c3h899/Full-Range-Speaker/Physical Cabinate/CAD Model/Cabinate_Assm_2.pdf

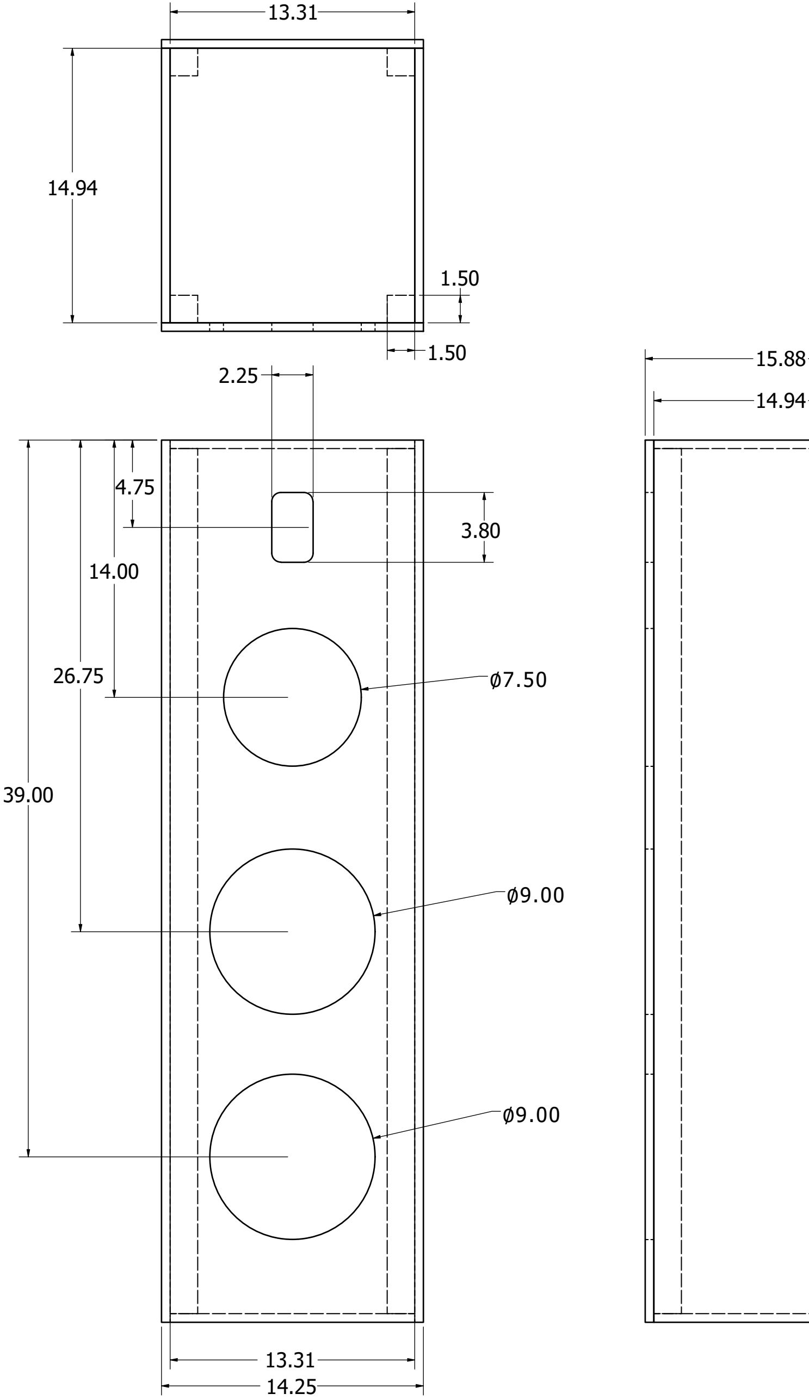
[picture p19: figure]

48.00

47.06
