c3h899/Full-Range-Speaker/Crossover Designs/Active Prototype [0] (Images)/PXL_20211031_224618647.jpg

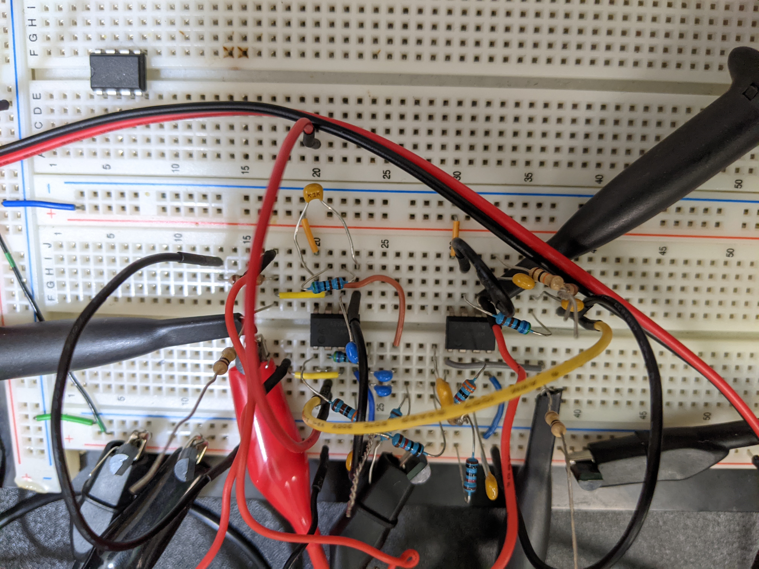
Crossover Designs/Active Prototype [0] (Images)/PXL_20211031_224618647.jpg
