c3h899/Full-Range-Speaker/Crossover Designs/Active Prototype [0] (Images)/PXL_20211031_230953043.jpg

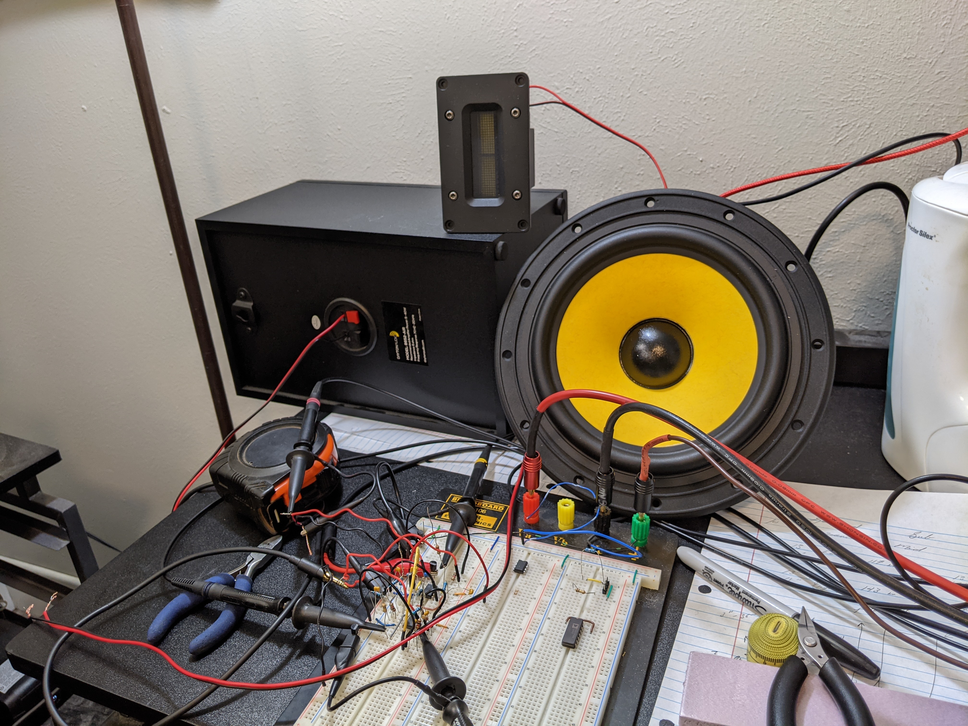
Crossover Designs/Active Prototype [0] (Images)/PXL_20211031_230953043.jpg
