c3h899/Full-Range-Speaker/Crossover Designs/Active/TPA3244 Ex Circ.PNG

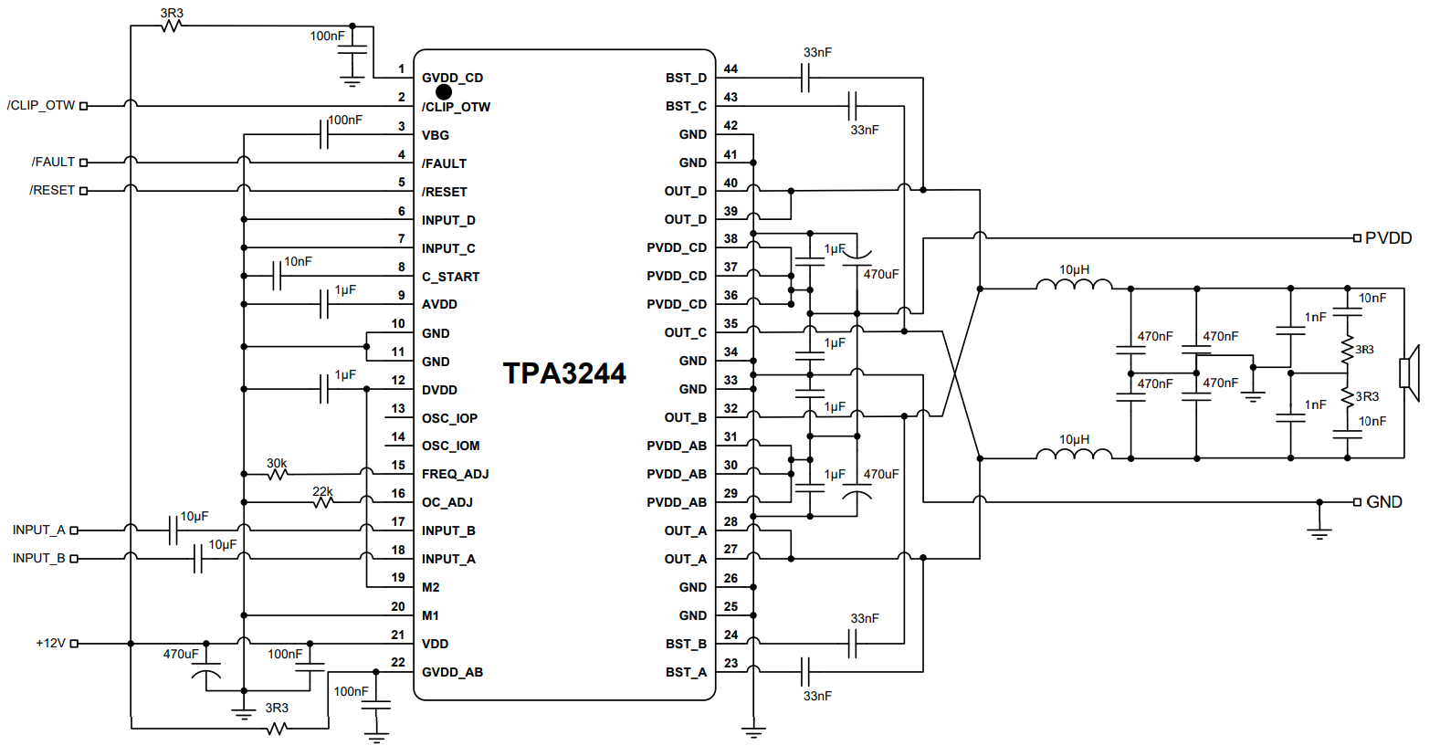
Crossover Designs/Active/TPA3244 Ex Circ.PNG
