c3h899/Full-Range-Speaker/Design Concept/Stock Photos/Dayton Audio DS270-PR (Passive Radiator).jpg

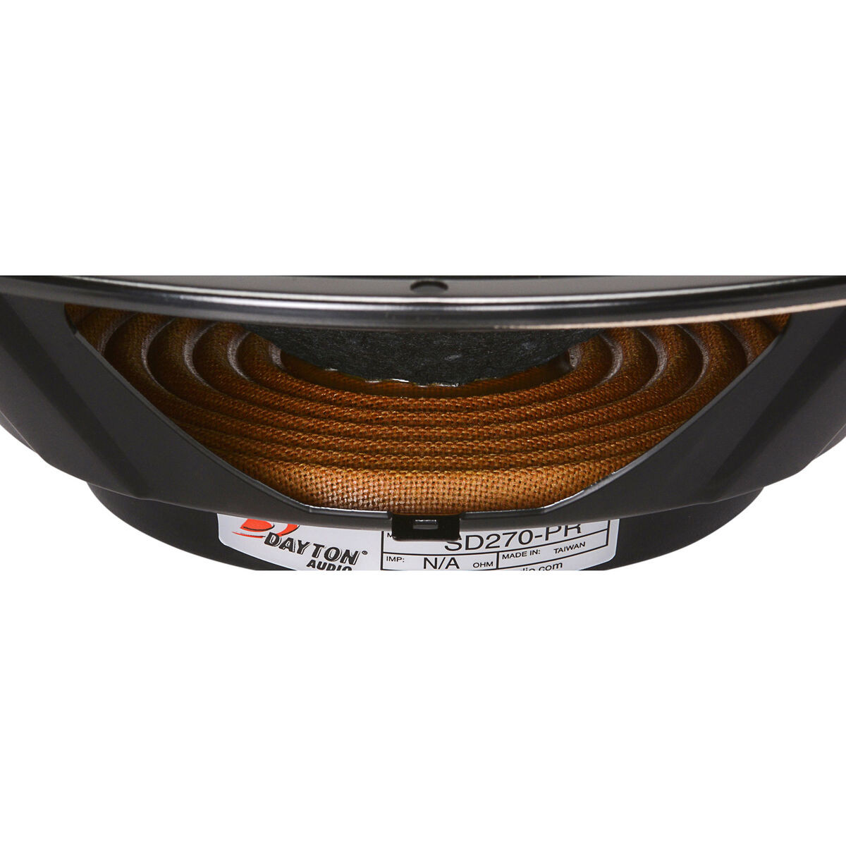
Design Concept/Stock Photos/Dayton Audio DS270-PR (Passive Radiator).jpg
