c3h899/Full-Range-Speaker/Design Concept/Stock Photos/Dayton Audio SD270A-88.jpg

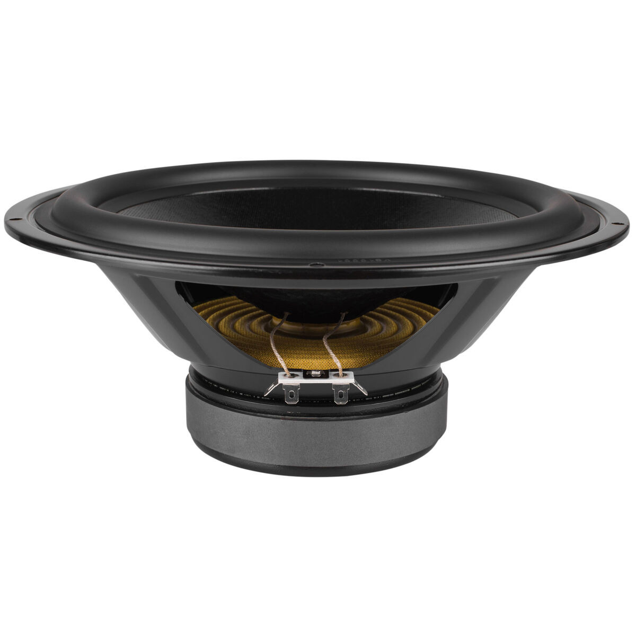
Design Concept/Stock Photos/Dayton Audio SD270A-88.jpg
