c3h899/Full-Range-Speaker/Design Concept/Stock Photos/Fountek Neo X 2.0 Ribbon Tweeter.jpg

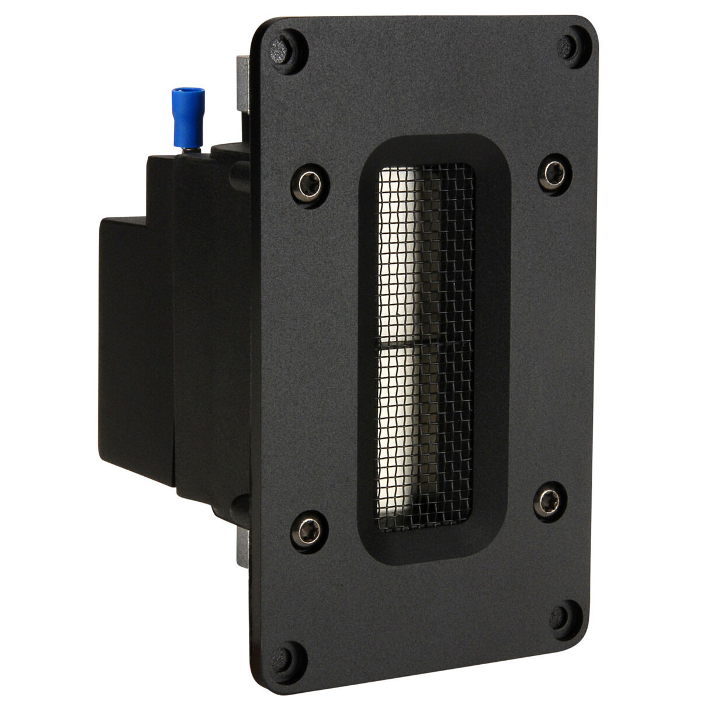
Design Concept/Stock Photos/Fountek Neo X 2.0 Ribbon Tweeter.jpg
