c3h899/Full-Range-Speaker/Design Concept/Stock Photos/Fountek, Neo CD 3.0 (Future Question).jpg

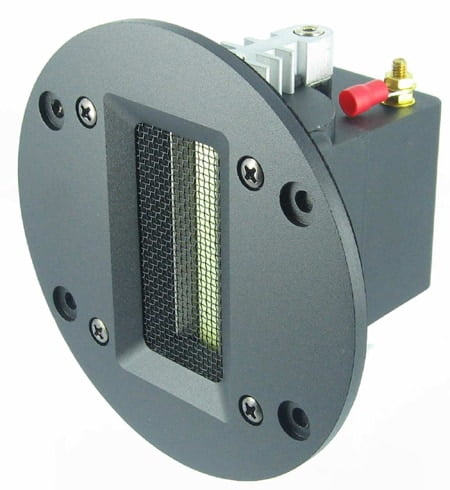
Design Concept/Stock Photos/Fountek, Neo CD 3.0 (Future Question).jpg
