c3h899/Full-Range-Speaker/Design Concept/Stock Photos/Hi-Vi, F6.jpg

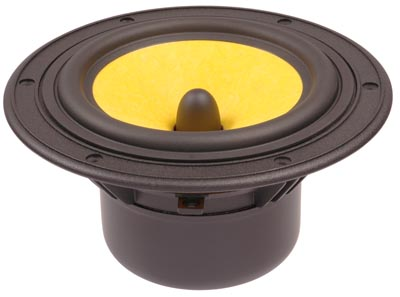
Design Concept/Stock Photos/Hi-Vi, F6.jpg
