c3h899/Full-Range-Speaker/Design Concept/Stock Photos/HiVi F8.jpg

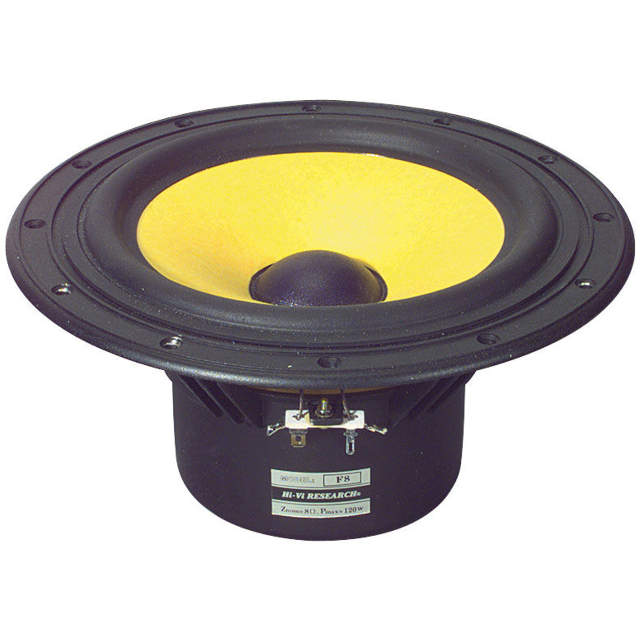
Design Concept/Stock Photos/HiVi F8.jpg
