c3h899/Full-Range-Speaker/Driver Impedance (DATS V3)/Cabinet/Drivers_In_Place.png

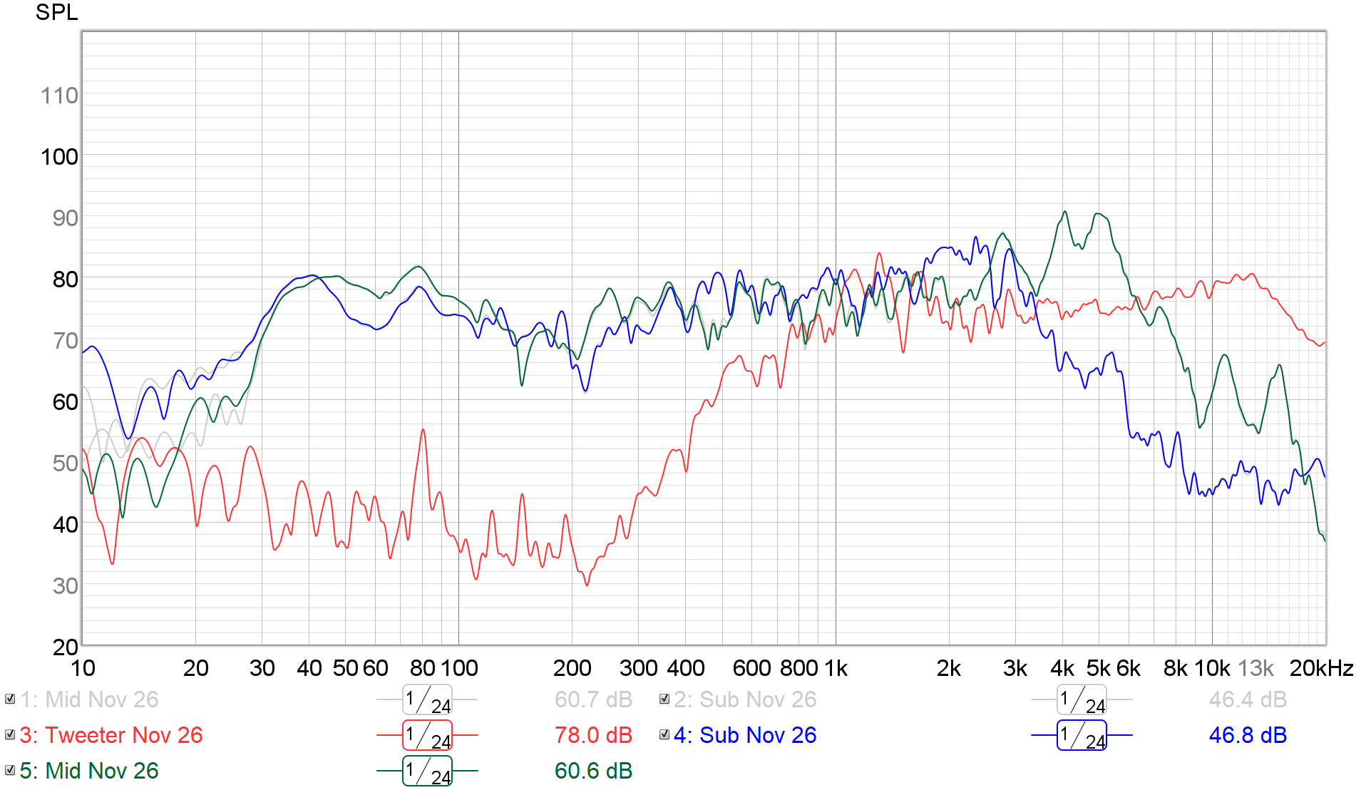
Driver Impedance (DATS V3)/Cabinet/Drivers_In_Place.png
