c3h899/Full-Range-Speaker/Driver Impedance (DATS V3)/Cabinet/Mid-Bass.png

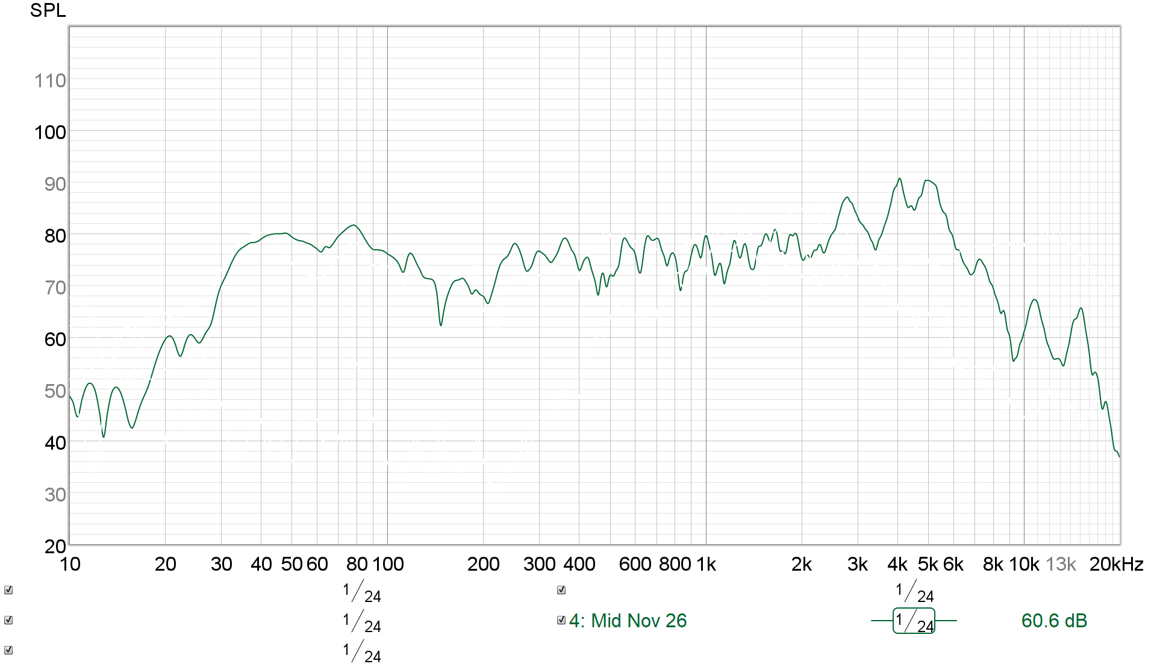
Driver Impedance (DATS V3)/Cabinet/Mid-Bass.png
