c3h899/Full-Range-Speaker/Driver Impedance (DATS V3)/Cabinet/Sub.png

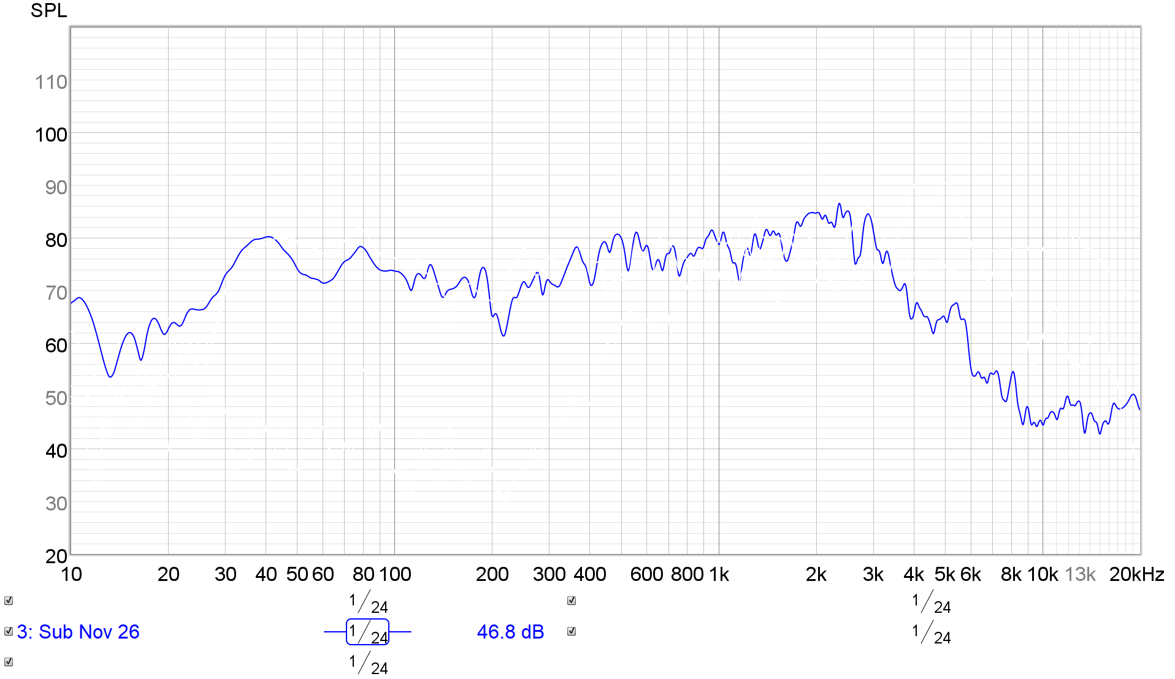
Driver Impedance (DATS V3)/Cabinet/Sub.png
