c3h899/Full-Range-Speaker/Driver Impedance (DATS V3)/Cabinet/Tweeter.png

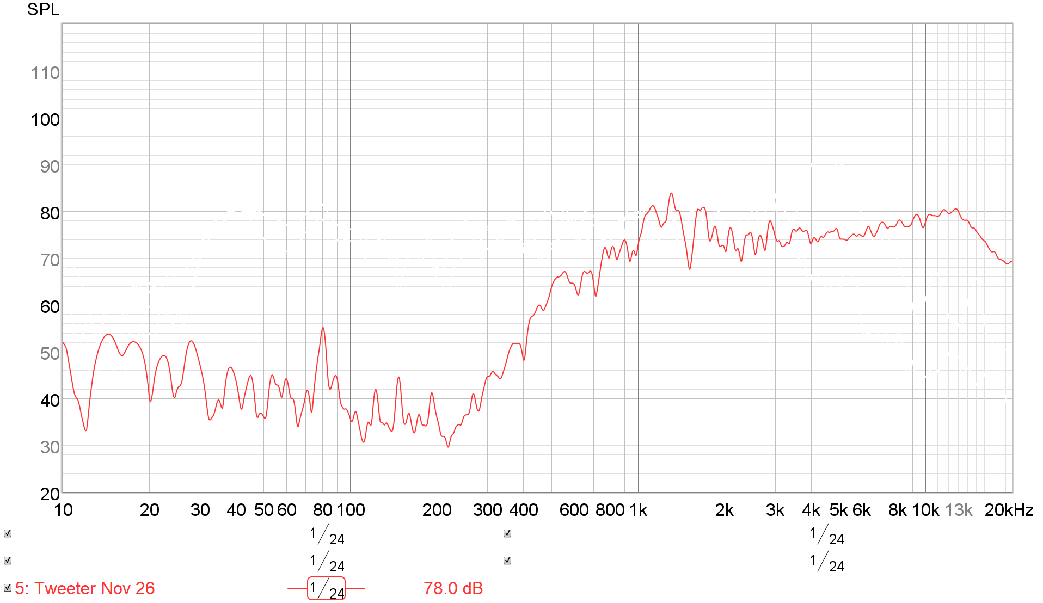
Driver Impedance (DATS V3)/Cabinet/Tweeter.png
