c3h899/Full-Range-Speaker/Physical Cabinate/Cabling [Images]/CableMatters Wall Plate (Rear) Only Banana Plug Compatible.jpg

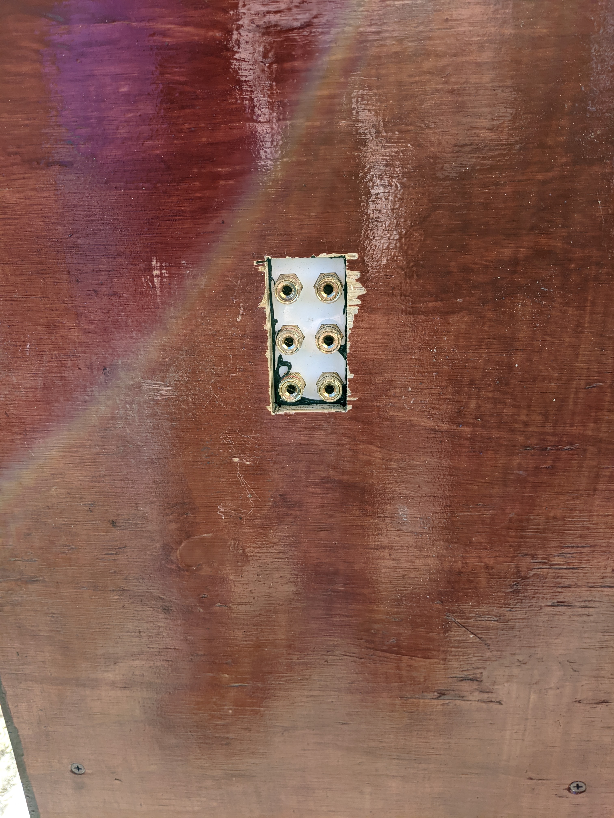
Physical Cabinate/Cabling [Images]/CableMatters Wall Plate (Rear) Only Banana Plug Compatible.jpg
