c3h899/Full-Range-Speaker/Physical Cabinate/Cabling [Images]/CableMatters Wall Plate.jpg

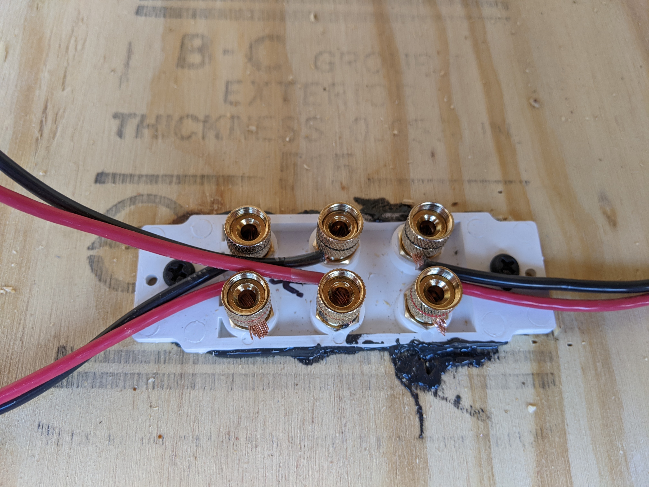
Physical Cabinate/Cabling [Images]/CableMatters Wall Plate.jpg
