c3h899/Full-Range-Speaker/Physical Cabinate/Cabling [Images]/Mid-Bass Cabling.jpg

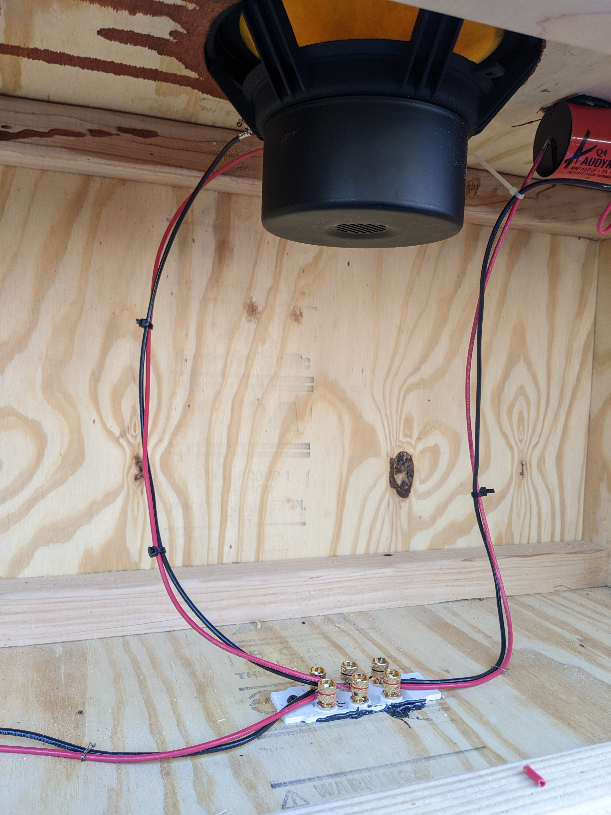
Physical Cabinate/Cabling [Images]/Mid-Bass Cabling.jpg
