c3h899/Full-Range-Speaker/Physical Cabinate/Cabling [Images]/Sub Cabling.jpg

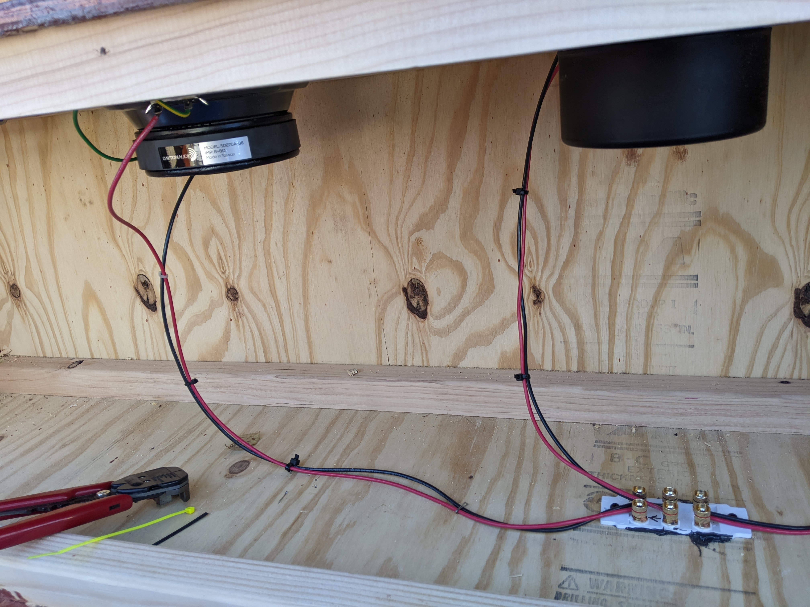
Physical Cabinate/Cabling [Images]/Sub Cabling.jpg
