c3h899/Full-Range-Speaker/Physical Cabinate/Cabling [Images]/Tweeter Cabling.jpg

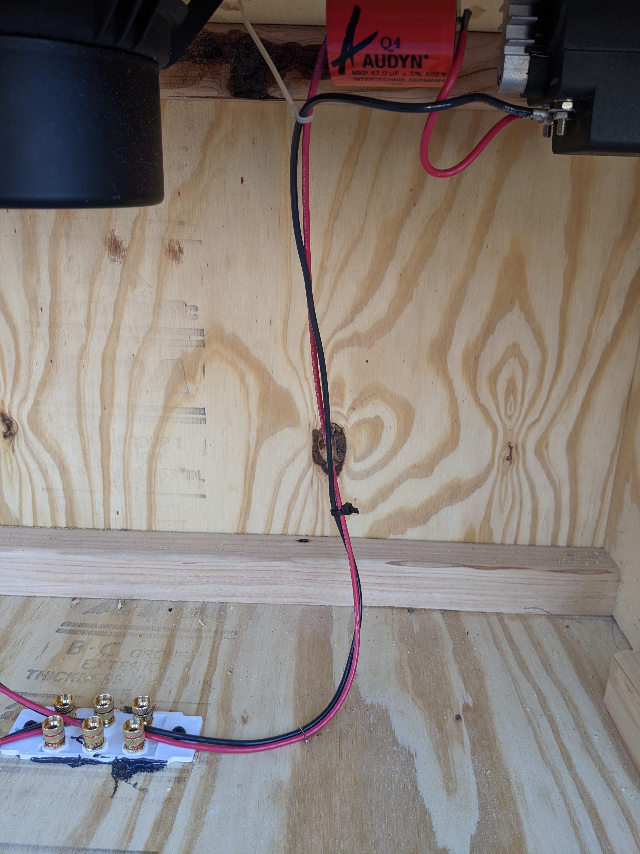
Physical Cabinate/Cabling [Images]/Tweeter Cabling.jpg
