c3h899/Full-Range-Speaker/Physical Cabinate/Cabling [Images]/Tweeter Series Cap.jpg

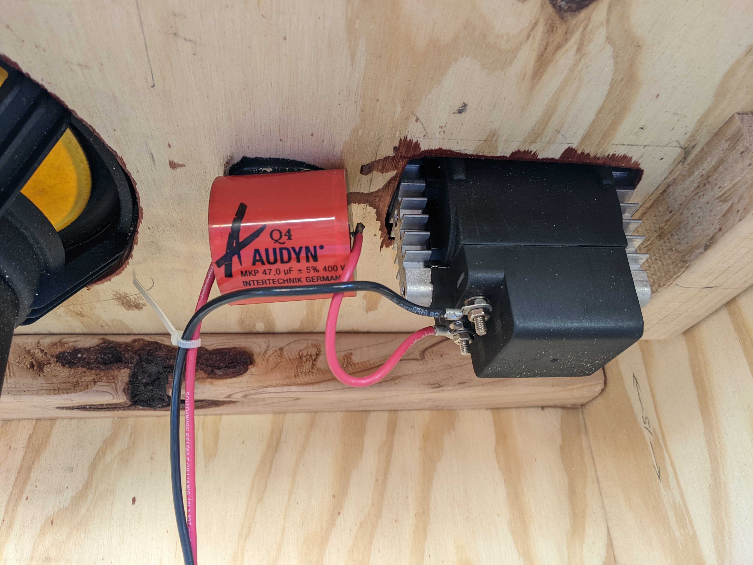
Physical Cabinate/Cabling [Images]/Tweeter Series Cap.jpg
