c3h899/Full-Range-Speaker/Physical Cabinate/Simulation (WinISD)/Not_Quite_Matched.png

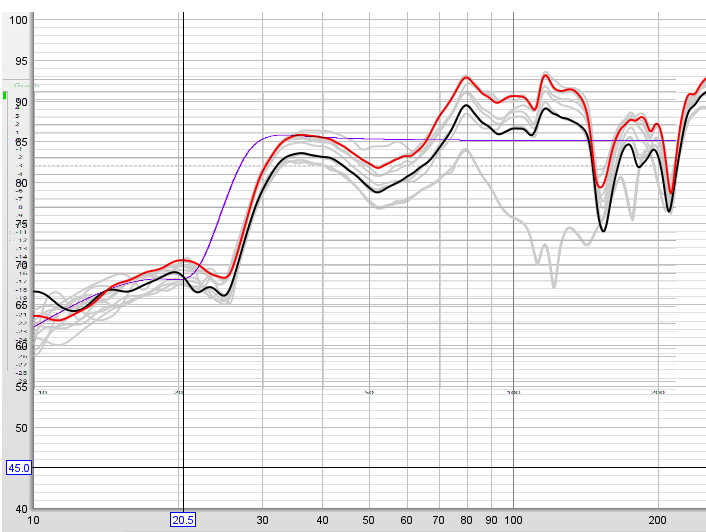
Physical Cabinate/Simulation (WinISD)/Not_Quite_Matched.png
