c3h899/Full-Range-Speaker/Power_Amplifier/R0.2_Images/PXL_20211216_221555118.jpg

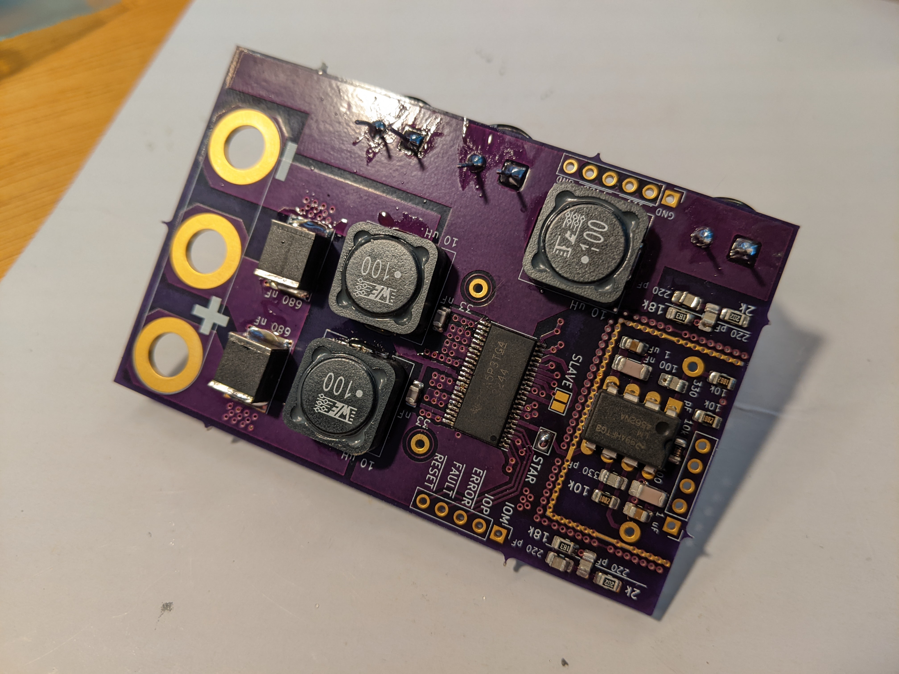
Power_Amplifier/R0.2_Images/PXL_20211216_221555118.jpg
