c3h899/Full-Range-Speaker/Power_Amplifier/R0.2_Images/PXL_20211222_185317508.jpg

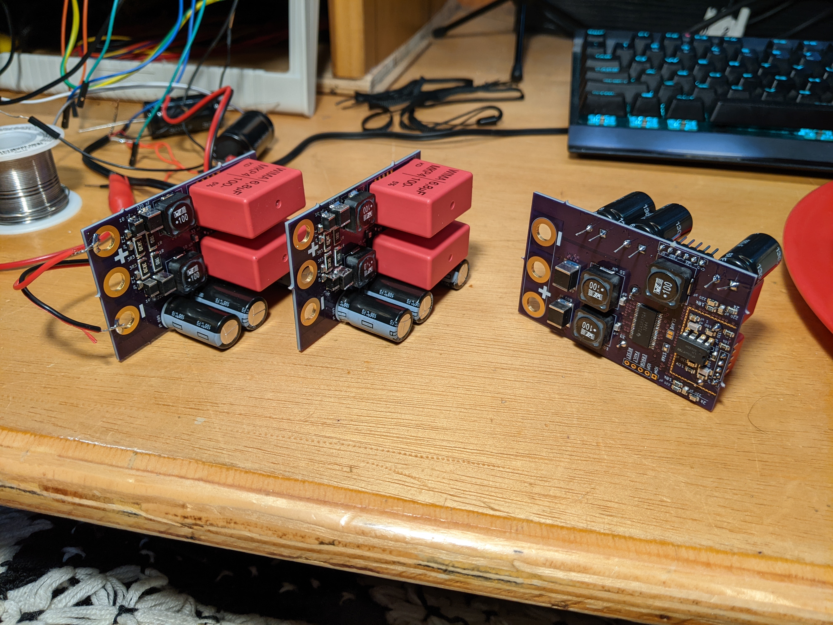
Power_Amplifier/R0.2_Images/PXL_20211222_185317508.jpg
