c3h899/Full-Range-Speaker/Power_Amplifier/R0.2_Images/PXL_20211222_185340925.jpg

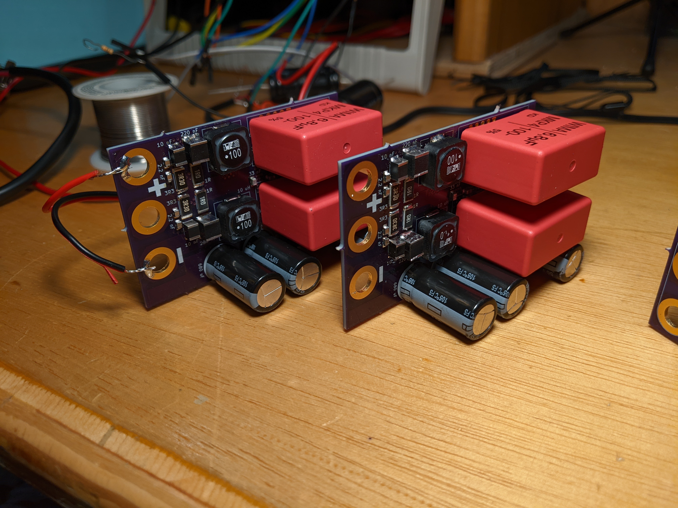
Power_Amplifier/R0.2_Images/PXL_20211222_185340925.jpg
