c3h899/Full-Range-Speaker/Power_Amplifier/R0.2_Plot/Discrete_Channel_Bot.png

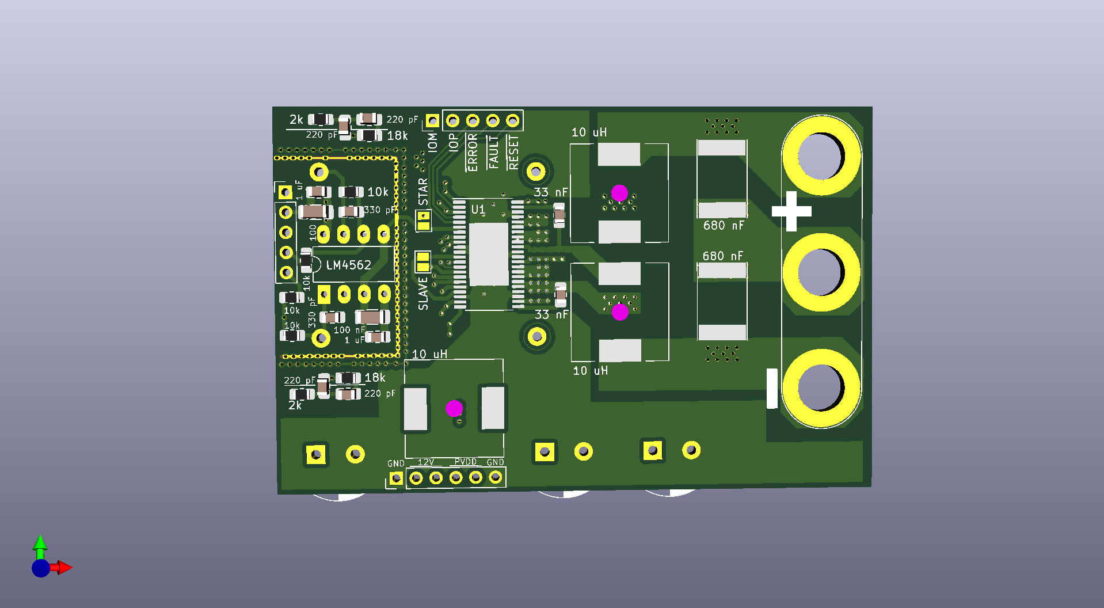
Power_Amplifier/R0.2_Plot/Discrete_Channel_Bot.png
