c3h899/Full-Range-Speaker/Power_Amplifier/R0_Images/Board_Bot_WIMA_Caps.jpg

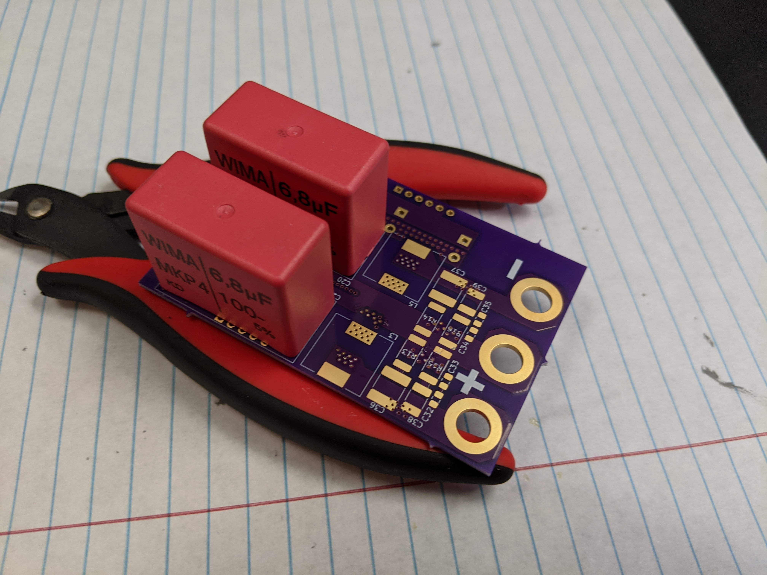
Power_Amplifier/R0_Images/Board_Bot_WIMA_Caps.jpg
