c3h899/Full-Range-Speaker/Power_Amplifier/R0_Images/Board_Empty_Bottom.jpg

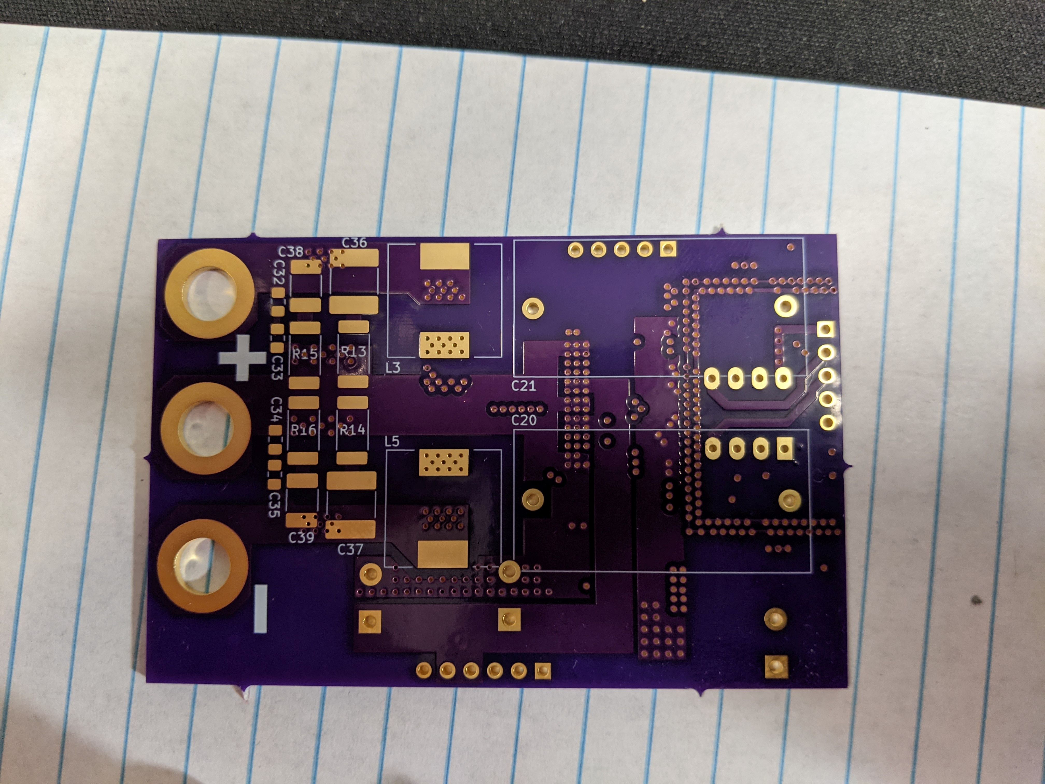
Power_Amplifier/R0_Images/Board_Empty_Bottom.jpg
