c3h899/Full-Range-Speaker/Power_Amplifier/R0_Images/Board_Top_Profile.jpg

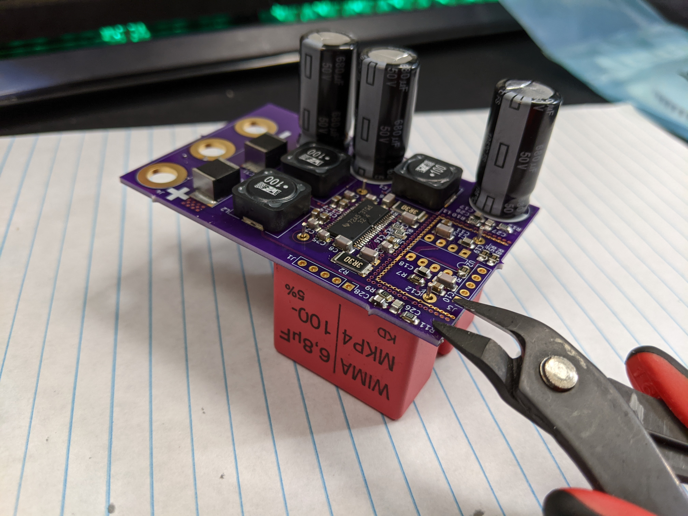
Power_Amplifier/R0_Images/Board_Top_Profile.jpg
