c3h899/Full-Range-Speaker/Power_Amplifier/R0_Images/Board_Top_Profile_2.jpg

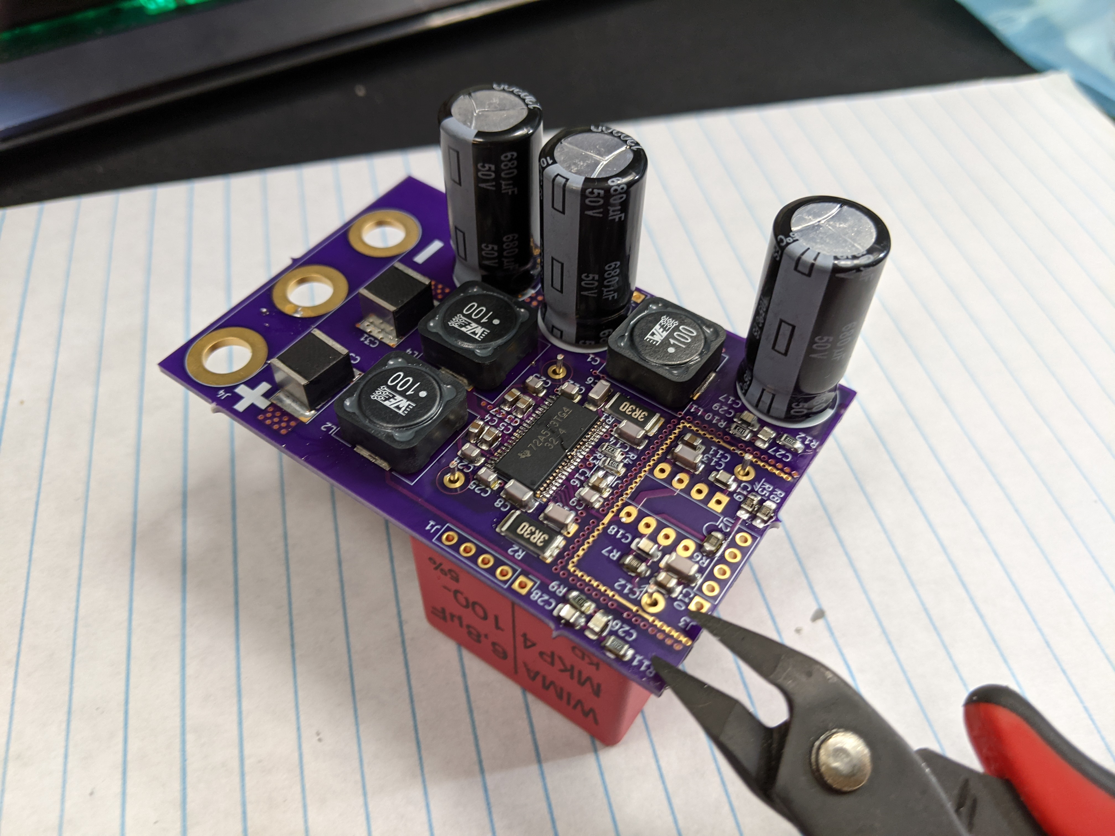
Power_Amplifier/R0_Images/Board_Top_Profile_2.jpg
