c3h899/Full-Range-Speaker/Report/Images/sp_active_xover_poc.png

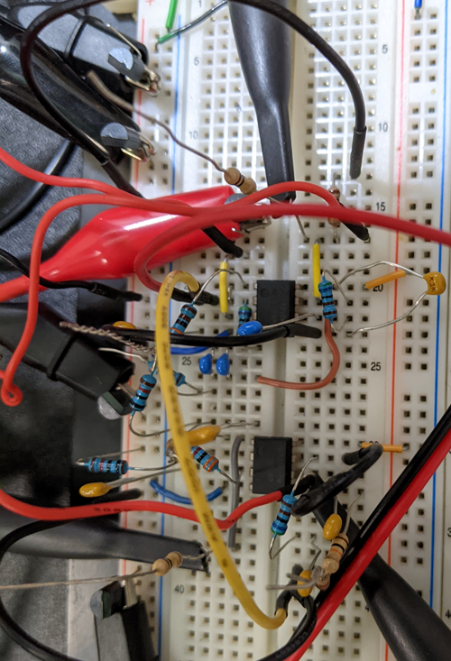
Report/Images/sp_active_xover_poc.png
