c3h899/Full-Range-Speaker/Report/Images/sp_miniDSP_1.png

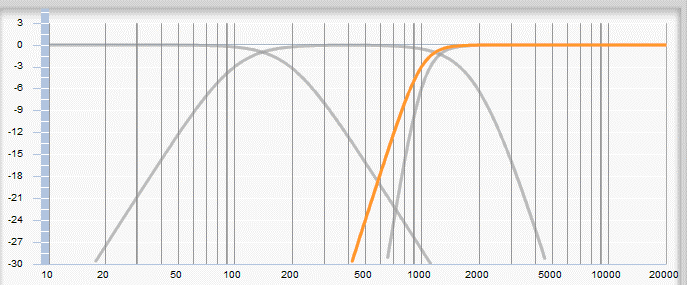
Report/Images/sp_miniDSP_1.png
