c3h899/Full-Range-Speaker/Report/Images/sp_pigtail.jpeg

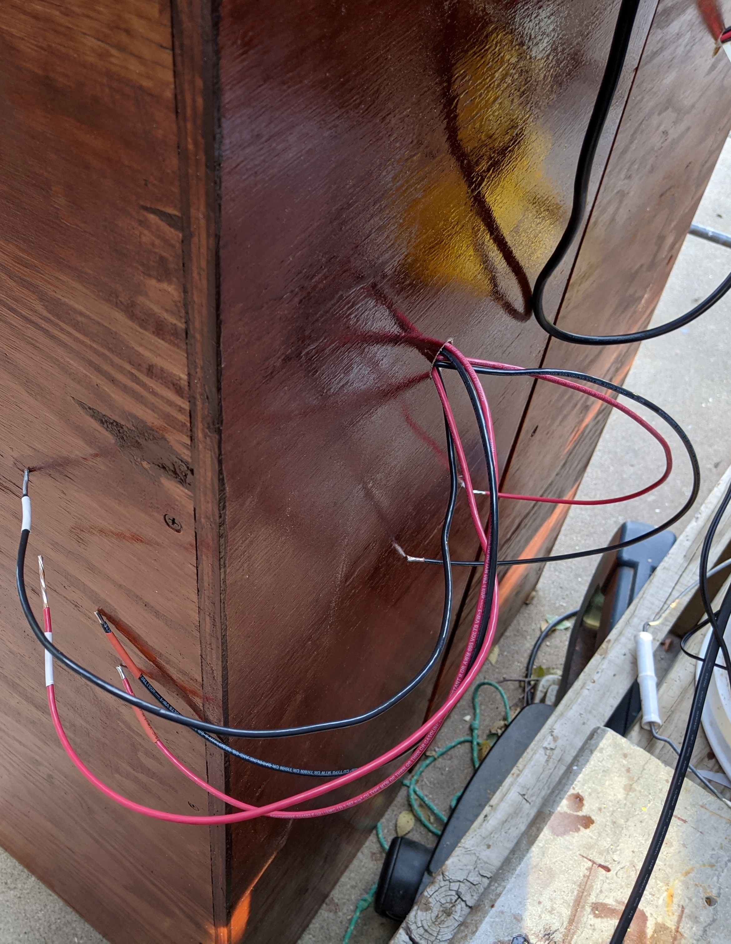
Report/Images/sp_pigtail.jpeg
