c3h899/Full-Range-Speaker/Purchases/Part Express - Speaker Components (1).pdf

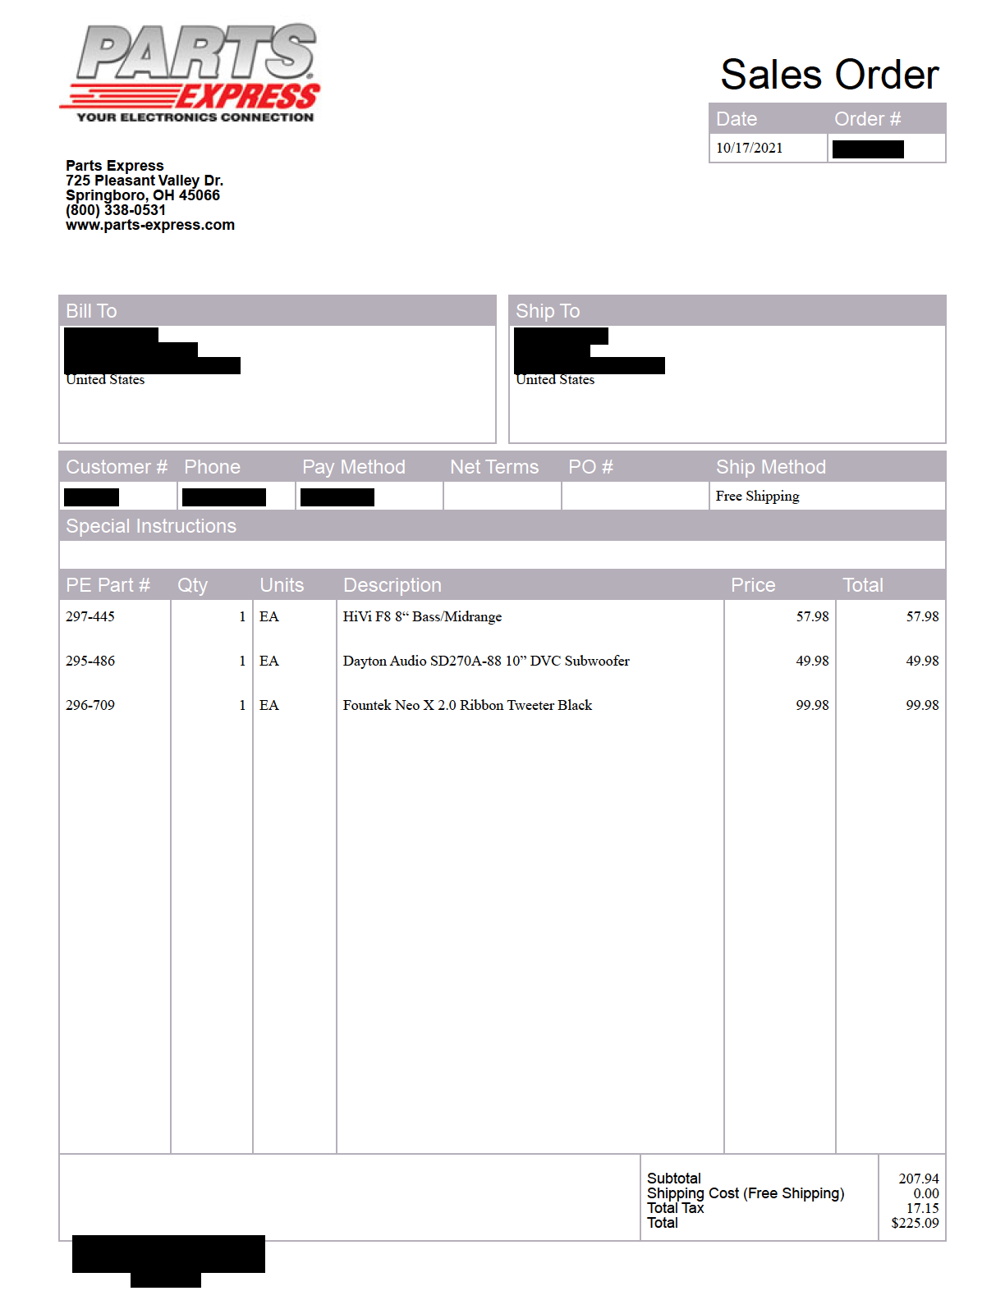
[picture p63: page 1]
