c3h899/Full-Range-Speaker/Purchases/Part Express - Speaker Components (2).pdf

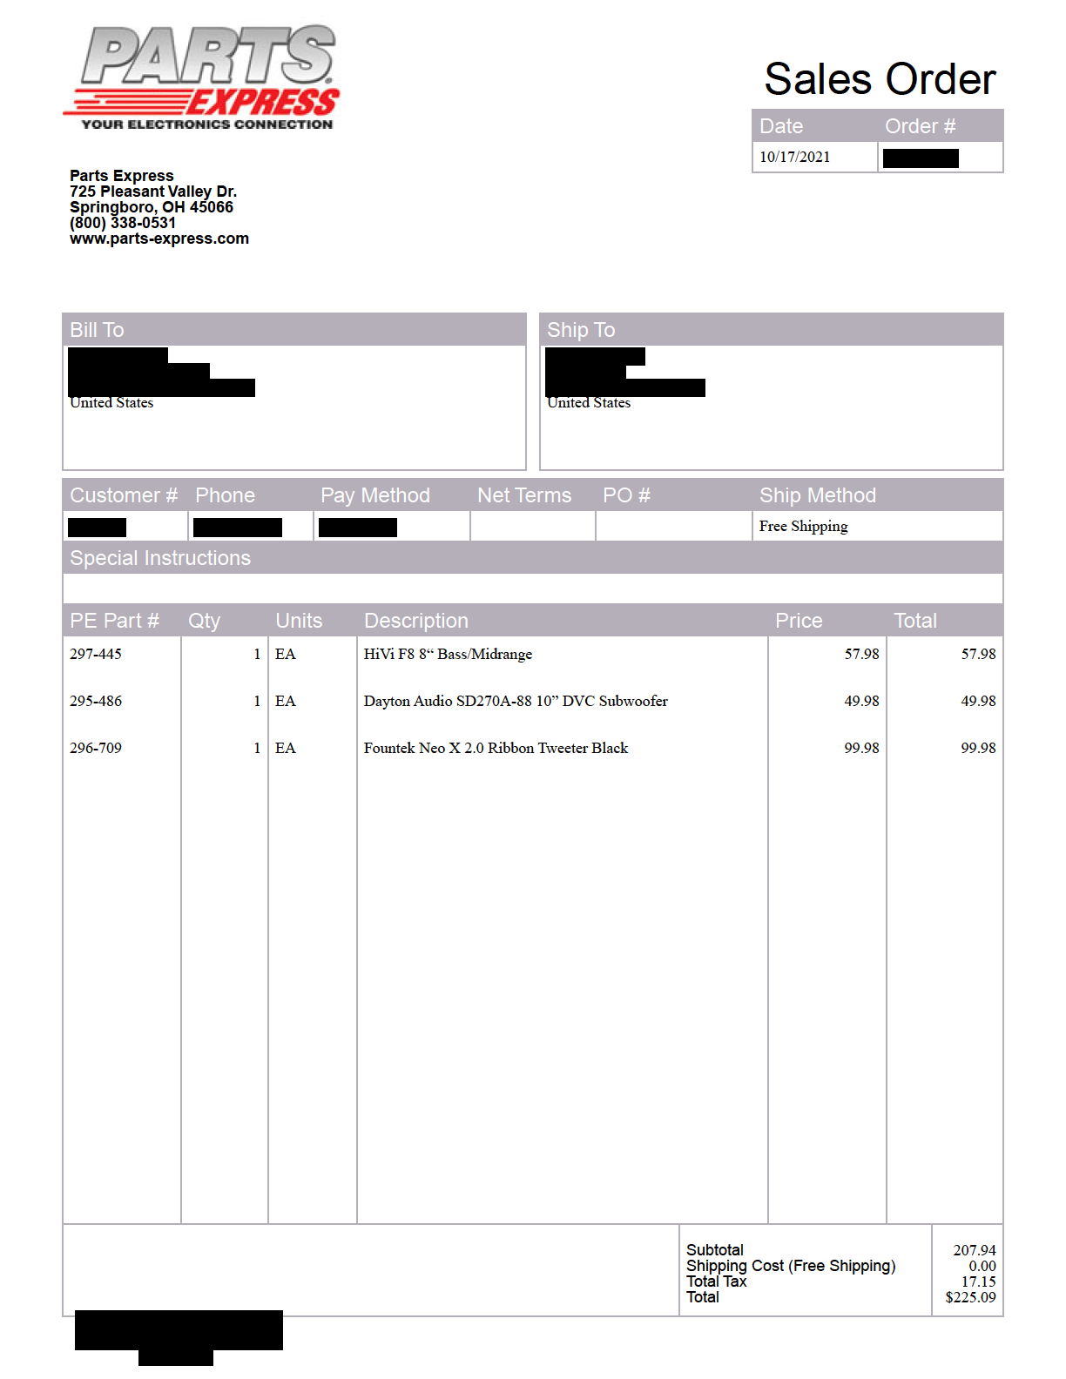
[picture p64: page 1]
