c3h899/Full-Range-Speaker/Materials.xlsx

Sheet: Summary
Bill of Materials (2 Speakers)
Electronic Components
Quantity | Description | Unit Cost | Sub-Total
2 | Active Crossover | 0 | 0
6 | Power Amplifier | 72.373 | 434.238
2 | Speaker Drivers (per Cabinate) | 241.92 | 483.84

Sheet: Active Crossover.
Single Speaker Amplifier |  |  |  |  |  |  |  | Quantity (2)
Item | Qty | Reference(s) | Value | Part | Datasheet | Digi Key [Link] | Note | Needed | Unit | Cost

Sheet: Power Amp.
 |  |  |  |  |  |  | Quantity (6)
Qty | Reference(s) | Value | Part | Datasheet | Digi Key [Link] | Note | Needed | Unit | Cost
3 | C1, C2, C17 | 680 uF | EEU-FS1H681B | https://industrial.panasonic.com/cdbs/www-data/pdf/RDF0000/ABA0000C1255.pdf | https://www.digikey.com/en/products/detail/EEU-FS1H681B/P122333CT-ND/7381332 | , | 18 | 1.166 | 20.988
7 | C3, C4, C5, C7, C10, C11, C16 | 1 uF | C0805C105M5PAC7800 | https://content.kemet.com/datasheets/KEM_C1006_X5R_SMD.pdf | https://www.digikey.com/en/products/detail/C0805C105M5PAC7800/399-C0805C105M5PAC7800CT-ND/12701548 | , | 42 | 0.4224 | 17.7408
6 | C6, C8, C12, C13, C14, C15 | 100 nF | C3216C0G1H104J160AA | https://product.tdk.com/en/system/files | https://www.digikey.com/en/products/detail/C3216C0G1H104J160AA/445-7694-1-ND/2733766 | , | 36 | 0.3564 | 12.8304
5 | C9, C22, C23, C24, C25 | 33 nF | C2012C0G1H333J125AA | https://product.tdk.com/en/system/files | https://www.digikey.com/en/products/detail/C2012C0G1H333J125AA/445-7523-1-ND/2733595 | , | 30 | 0.1812 | 5.436
2 | C18, C19 | 330 pF | ECH-U1H331JX5 | https://industrial.panasonic.com/ww/products/pt/film-cap-electroequip/models/ECHU1H331JX5 | https://www.digikey.com/en/products/detail/ECH-U1H331JX5/PCF1322CT-ND/353794 | , | 12 | 0.2304 | 2.7648
2 | C20, C21 | 6.8 uF | MKP4D046806F00JSSD | https://www.wima.de/wp-content/uploads/media/e_WIMA_MKP_4.pdf | https://www.digikey.com/en/products/detail/MKP4D046806F00JSSD/1928-1535-ND/9370464 | , | 12 | 2.897 | 34.764
4 | C26, C27, C28, C29 | 220 pF | ECH-U1H221JX5 | https://industrial.panasonic.com/ww/products/pt/film-cap-electroequip/models/ECHU1H221JX5 | https://www.digikey.com/en/products/detail/ECH-U1H221JX5/PCF1320CT-ND/353792 | , | 24 | 0.2304 | 5.5296
2 | C30, C31 | 680 nF | SMDIC03680TB00MQ00 | https://www.wima.de/wp-content/uploads/media/e_WIMA_SMD_PPS.pdf | https://www.digikey.com/en/products/detail/wima/SMDIC03680TB00MQ00/9449100 | , | 12 | 1.953 | 23.436
4 | C32, C33, C34, C35 | 2.2 nF | ECH-U1H222GX5 | https://industrial.panasonic.com/ww/products/pt/film-cap-electroequip/models/ECHU1H222GX5 | https://www.digikey.com/product-detail/en/ECH-U1H222GX5/PCF1300CT-ND/353772 | , | 24 | 0.2322 | 5.5728
2 | C36, C37 | 220 nF | SMDID03220QB00MP00 | https://www.wima.de/wp-content/uploads/media/e_WIMA_SMD_PPS.pdf | https://www.digikey.com/en/products/detail/SMDID03220QB00MP00/1928-1907-1-ND/9449183 | , | 12 | 1.41 | 16.92
2 | C38, C39 | 10 nF | SMDID02100KA00MP00 | https://www.wima.de/wp-content/uploads/media/e_WIMA_SMD_PPS.pdf | https://www.digikey.com/en/products/detail/SMDID02100KA00MP00/1928-1903-1-ND/9449179 | , | 12 | 1.227 | 14.724
2 | J1, J3 | Conn_01x05_Male |  | ~ |  |  | 12 | 0 | 0
1 | J2 | Conn_01x06_Male |  | ~ |  |  | 6 | 0 | 0
1 | J4 | Banna Jack |  | ~ |  |  | 6 | 0 | 0
1 | JP1 | Jumper_NO_Small | ON BOARD | N/A | N/A |  | 6 | 0 | 0
5 | L1, L2, L3, L4, L5 | 10 uH | 74477110 | https://www.we-online.com/katalog/datasheet/74477110.pdf | https://www.digikey.com/en/products/detail/w%C3%BCrth-elektronik/74477110/1638613 | , | 30 | 2.109 | 63.27
4 | R1, R2, R15, R16 | 3R3 | CRS2512-FW-3R30ELF | https://www.bourns.com/data/global/pdfs/CRS.pdf | https://www.digikey.com/en/products/detail/bourns-inc/CRS2512-FW-3R30ELF/5778664 | , | 24 | 0.583 | 13.992
1 | R3 | 30k | ERA-6ARB303V | https://industrial.panasonic.com/cdbs/www-data/pdf/RDM0000/AOA0000C307.pdf | https://www.digikey.com/en/products/detail/panasonic-electronic-components/ERA-6ARB303V/3073756 | , | 6 | 0.508 | 3.048
1 | R4 | 22k | ERA-6ARB223V | https://industrial.panasonic.com/cdbs/www-data/pdf/RDM0000/AOA0000C307.pdf | https://www.digikey.com/en/products/detail/panasonic-electronic-components/ERA-6ARB223V/3073750 | , | 6 | 0.533 | 3.198
4 | R5, R6, R7, R8 | 10k | RNCF0805BKT10K0 | https://www.seielect.com/catalog/sei-rncf.pdf | https://www.digikey.com/en/products/detail/stackpole-electronics-inc/RNCF0805BKT10K0/1711521 | , | 24 | 0.536 | 12.864
2 | R9, R10 | 18k | ERA-6ARB183V | https://industrial.panasonic.com/cdbs/www-data/pdf/RDM0000/AOA0000C307.pdf | https://www.digikey.com/en/products/detail/panasonic-electronic-components/ERA-6ARB183V/3073746 | , | 12 | 0.533 | 6.396
2 | R11, R12 | 2k | ERA-6ARB202V | https://industrial.panasonic.com/cdbs/www-data/pdf/RDM0000/AOA0000C307.pdf | https://www.digikey.com/en/products/detail/panasonic-electronic-components/ERA-6ARB202V/3073747 | , | 12 | 0.508 | 6.096
2 | R13, R14 | 1R | CRM2512-JW-1R0ELF | https://www.bourns.com/docs/product-datasheets/crm.pdf | https://www.digikey.com/en/products/detail/bourns-inc/CRM2512-JW-1R0ELF/2563950 | , | 12 | 0.2728 | 3.2736
1 | U1 | TPA3244 | TPA3244DDWR | https://www.ti.com/lit/ds/symlink/tpa3244.pdf | https://www.digikey.com/en/products/detail/texas-instruments/TPA3244DDWR/6566104 | , | 6 | 5.578 | 33.468
1 | U2 | LM4562 | LM4562NA/NOPB | http://www.ti.com/lit/ds/symlink/lm4562.pdf | https://www.digikey.com/en/products/detail/texas-instruments/LM4562NA-NOPB/1217793 | , | 6 | 2.221 | 13.326
2 | PCB |  | OSH PARK (Q.3) |  |  |  | 2 | 57.3 | 114.6
 |  |  |  |  |  |  | Sub-Total |  | 434.238

Sheet: Speaker Drivers
Speaker Drivers |  |  |  |  |  | Quantity (2)
Item | Qty | Part | Datasheet | Parts Express [Link] | Note | Needed | Unit | Cost
296-709 | 2 | Fountek Neo X 2.0 Ribbon Tweeter Black | https://www.parts-express.com/pedocs/specs/fountek-neo-x-20-specifications.pdf | https://www.parts-express.com/Fountek-Neo-X-2.0-Ribbon-Tweeter-Black-296-709 | , Clearance | 2 | 99.98 | 199.96
297-445 | 2 | HiVi F8 8" Bass/Midrange | https://www.parts-express.com/pedocs/specs/297-445-hi-vi-f8-specifications-45089.pdf | https://www.parts-express.com/HiVi-F8-8-Bass-Midrange-297-445 | , | 2 | 57.98 | 115.96
295-486 | 2 | Dayton Audio SD270A-88 10" DVC Subwoofer | https://www.parts-express.com/pedocs/specs/295-486-dayton-audio-sd270a-88-specifications-47085.pdf | https://www.parts-express.com/Dayton-Audio-SD270A-88-10-DVC-Subwoofer-295-486 | , | 2 | 49.98 | 99.96
295-494 | 2 | Dayton Audio DS270-PR 10" Designer Series Passive Radiator | https://www.parts-express.com/Dayton-Audio-DS270-PR-10-Designer-Series-Passive-Radiator-295-494 | https://www.parts-express.com/Dayton-Audio-DS270-PR-10-Designer-Series-Passive-Radiator-295-494 | , | 2 | 33.98 | 67.96
 |  |  |  |  |  | Sub-Total |  | 483.84
