c3h899/Full-Range-Speaker/Design Concept/Components/PXL_20211025_003414214.jpg

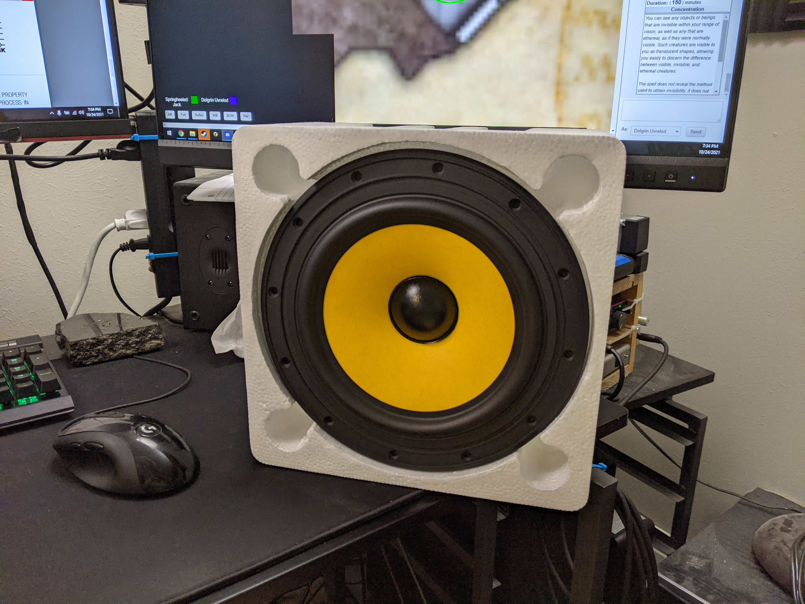
Design Concept/Components/PXL_20211025_003414214.jpg
