c3h899/Full-Range-Speaker/Design Concept/Components/PXL_20211025_011501447.jpg

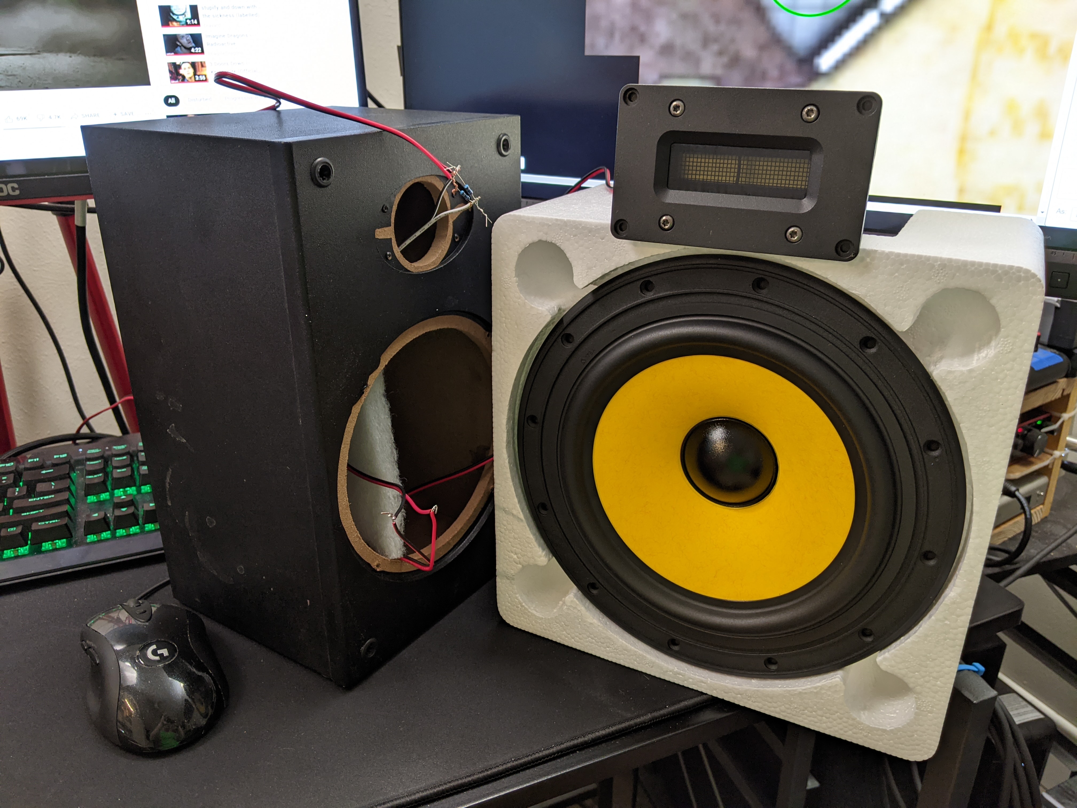
Design Concept/Components/PXL_20211025_011501447.jpg
