c3h899/Full-Range-Speaker/Design Concept/Components/PXL_20211025_014124840.jpg

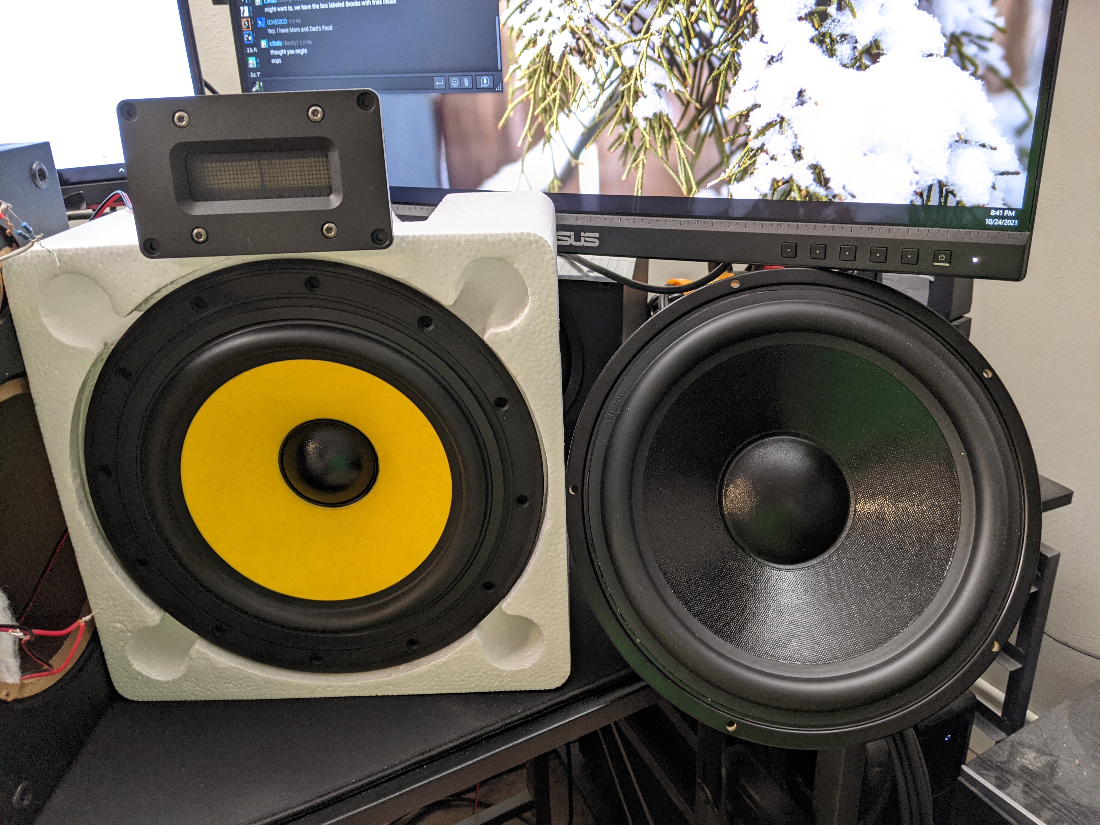
Design Concept/Components/PXL_20211025_014124840.jpg
