c3h899/Full-Range-Speaker/Physical Cabinate/CAD Model/TB_Sides.stp

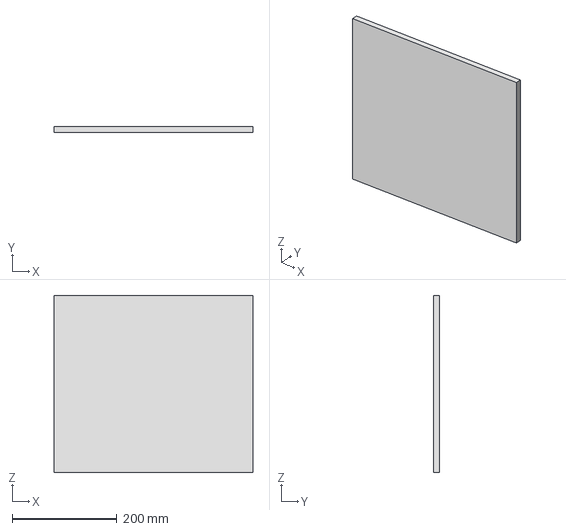
[picture p68: CAD file, 2021-11-26]
Physical Cabinate/CAD Model/TB_Sides.stp
379.4 x 11.9 x 338.1 mm
