c3h899/Full-Range-Speaker/Physical Cabinate/CAD Model/Front.stp

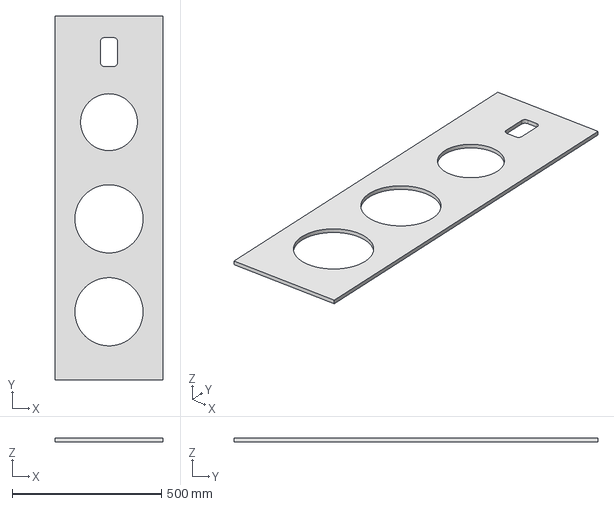
[picture p69: CAD file, 2021-11-26]
Physical Cabinate/CAD Model/Front.stp
362.0 x 1219.2 x 11.9 mm
