c3h899/Full-Range-Speaker/Physical Cabinate/CAD Model/Cabinate_Assm.stp

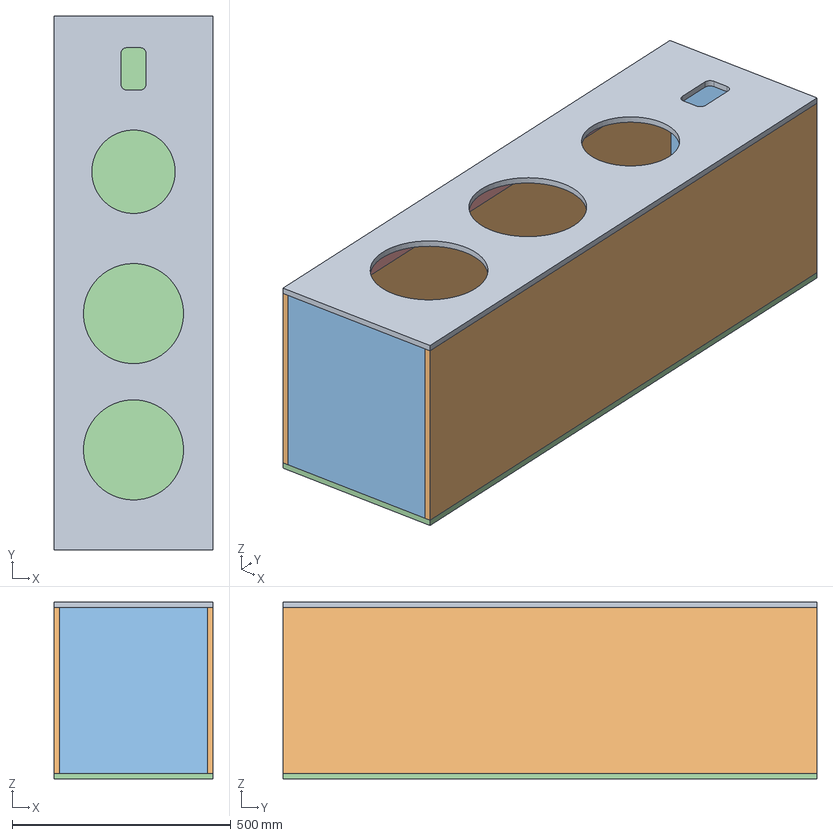
[picture p70: CAD file, 2021-11-26]
Physical Cabinate/CAD Model/Cabinate_Assm.stp
362.0 x 1219.2 x 403.2 mm
Front
LR_Sides x 2
TB_Sides x 2
Back
Int_Uprights x 4
