c3h899/Full-Range-Speaker/Physical Cabinate/CAD Model/LR_Sides.stp

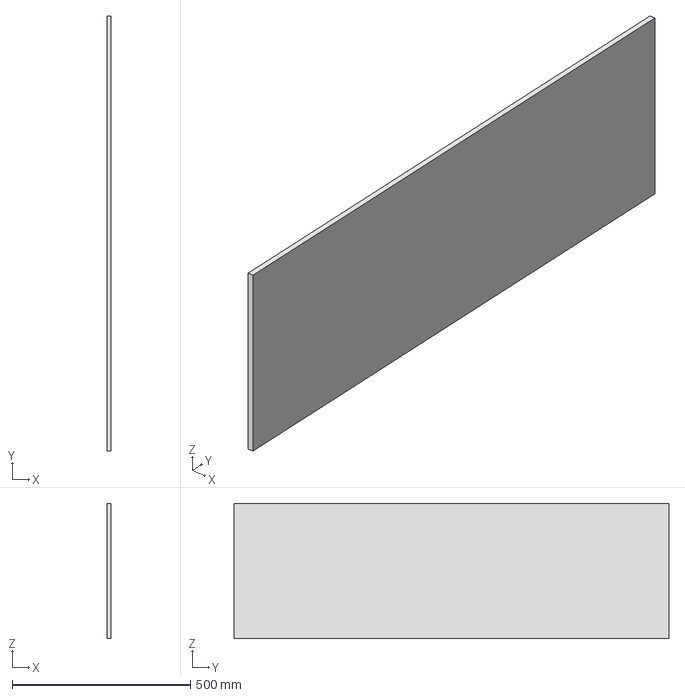
[picture p71: CAD file, 2021-11-26]
Physical Cabinate/CAD Model/LR_Sides.stp
11.9 x 1219.2 x 379.4 mm
