c3h899/Full-Range-Speaker/(list of files, cad)

Other CAD files:
Physical Cabinate/CAD Model/Back.ipt
Physical Cabinate/CAD Model/Cabinate_Assm.iam
Physical Cabinate/CAD Model/Front.ipt
Physical Cabinate/CAD Model/Int_Uprights.ipt
Physical Cabinate/CAD Model/LR_Sides.ipt
Physical Cabinate/CAD Model/TB_Sides.ipt
