c3h899/Full-Range-Speaker/Physical Cabinate/Construction [Images]/6-Cabinets (Staining).jpg

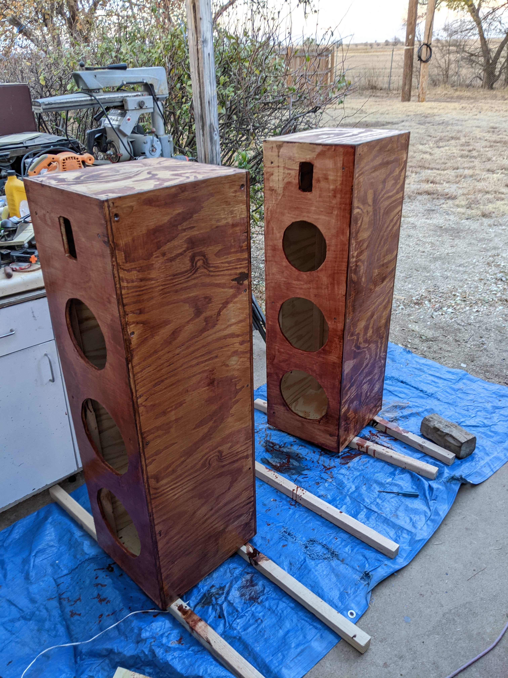
Physical Cabinate/Construction [Images]/6-Cabinets (Staining).jpg
