c3h899/Full-Range-Speaker/Physical Cabinate/Construction [Images]/7-Assembled.jpg

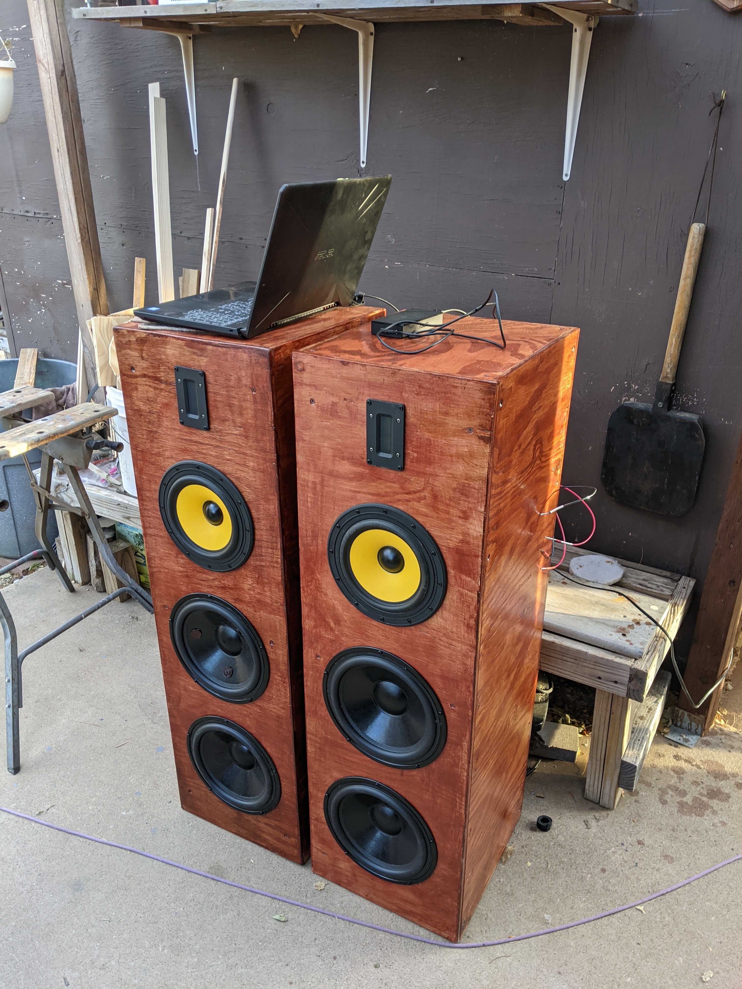
Physical Cabinate/Construction [Images]/7-Assembled.jpg
