c3h899/Full-Range-Speaker/Physical Cabinate/Construction [Images]/8-Active Crossover (Prototyping).jpg

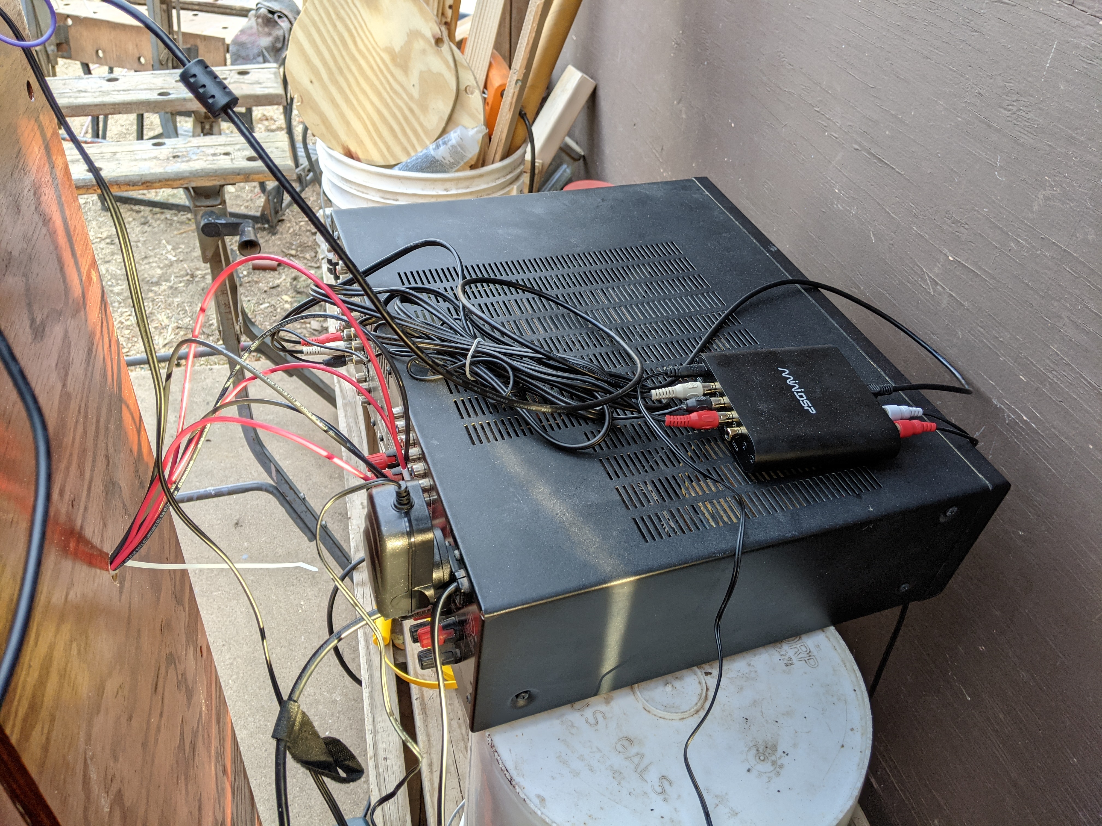
Physical Cabinate/Construction [Images]/8-Active Crossover (Prototyping).jpg
