c3h899/Full-Range-Speaker/Physical Cabinate/Construction [Images]/9a-Cabinet Pigtails.jpg

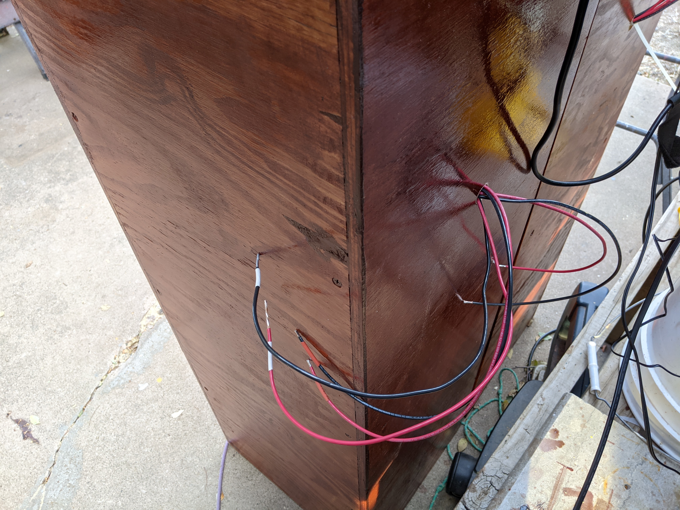
Physical Cabinate/Construction [Images]/9a-Cabinet Pigtails.jpg
