c3h899/Full-Range-Speaker/Physical Cabinate/Construction [Images]/9b-Tri-Amp Configuration.jpg

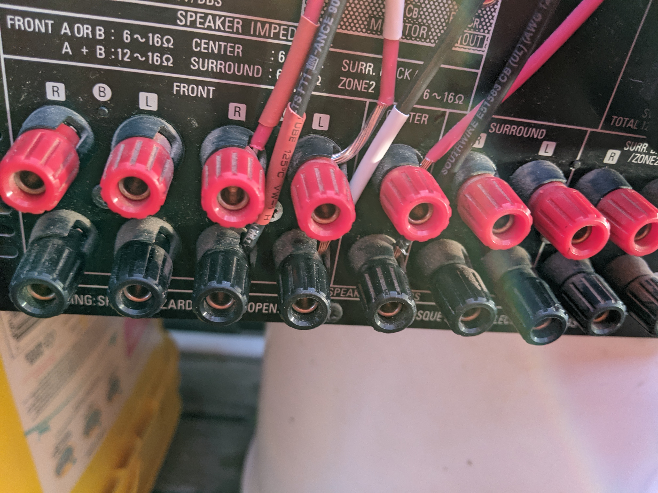
Physical Cabinate/Construction [Images]/9b-Tri-Amp Configuration.jpg
