c3h899/Full-Range-Speaker/Crossover Designs/Passive (Based on Measurement)/Proto_3/SPL.jpg

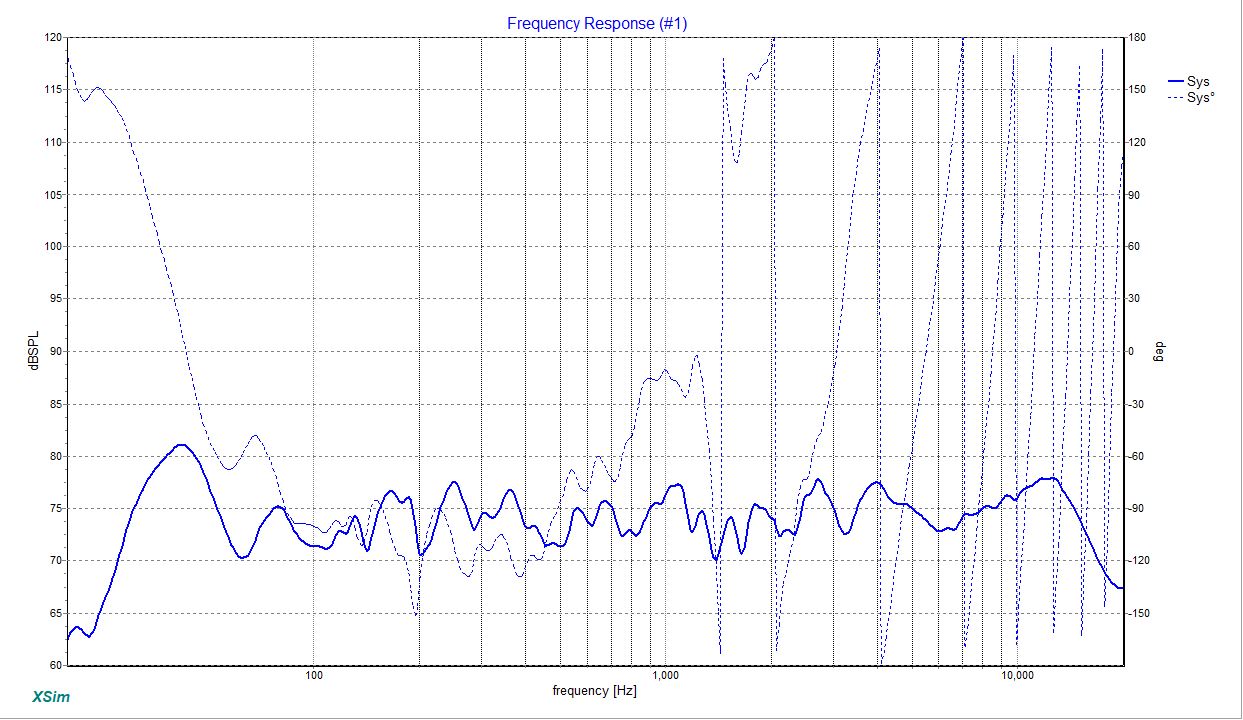
Crossover Designs/Passive (Based on Measurement)/Proto_3/SPL.jpg
