c3h899/Full-Range-Speaker/Physical Cabinate/Extruded Polystyrene Test Structures/1-Prototype.jpg

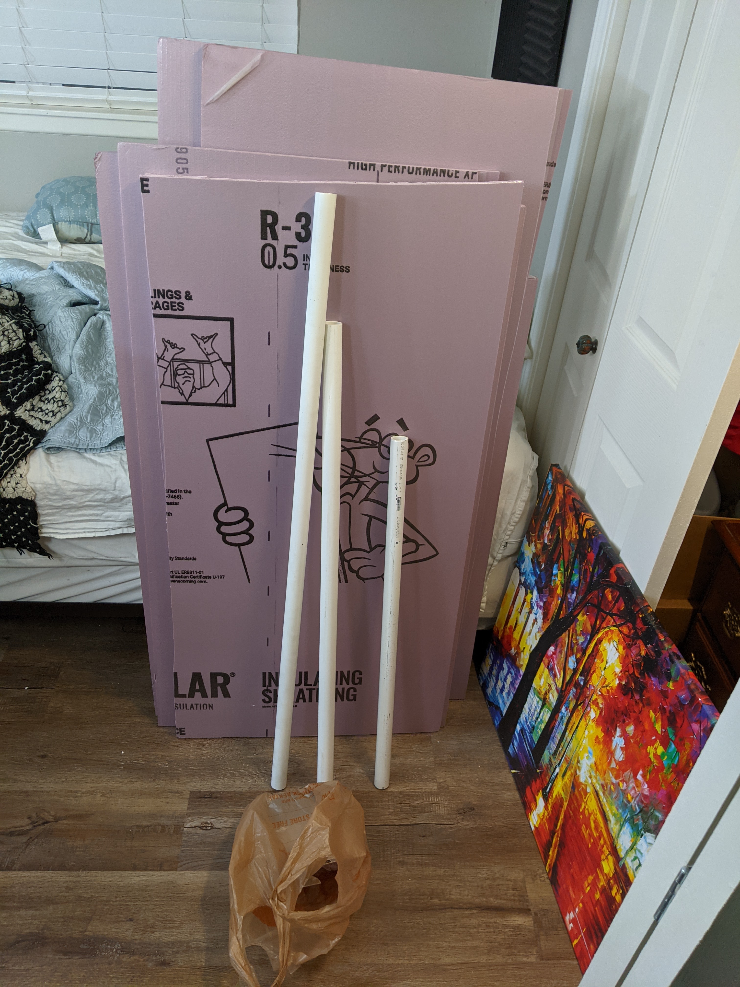
Physical Cabinate/Extruded Polystyrene Test Structures/1-Prototype.jpg
