c3h899/Full-Range-Speaker/Physical Cabinate/Extruded Polystyrene Test Structures/PXL_20211028_025016039.jpg

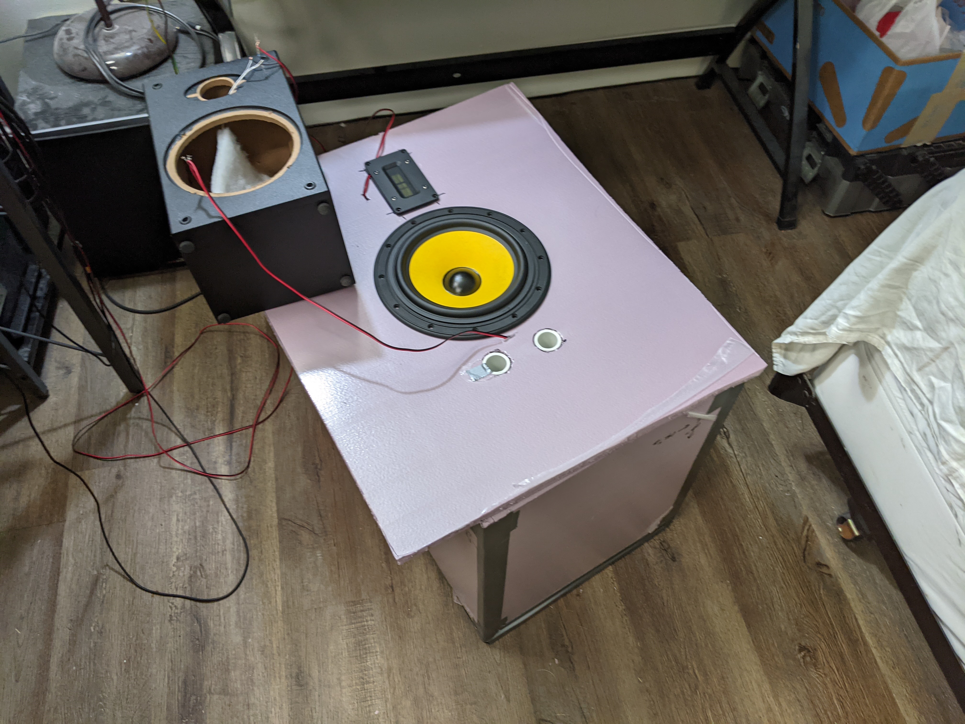
Physical Cabinate/Extruded Polystyrene Test Structures/PXL_20211028_025016039.jpg
