c3h899/Full-Range-Speaker/Physical Cabinate/Extruded Polystyrene Test Structures/PXL_20211029_021520648.jpg

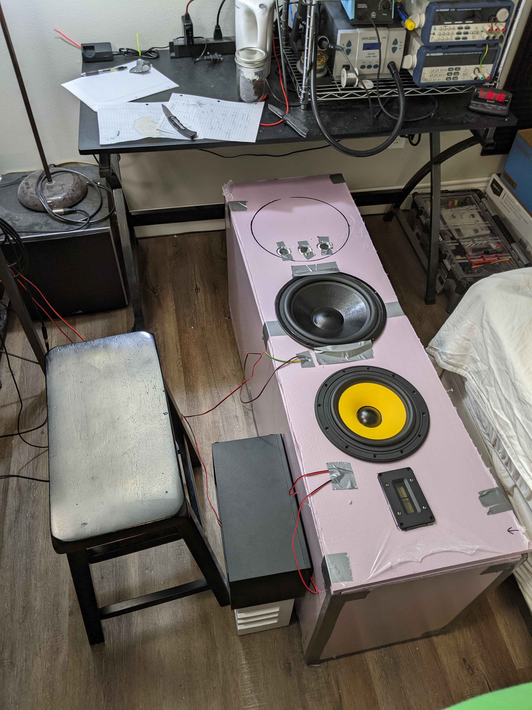
Physical Cabinate/Extruded Polystyrene Test Structures/PXL_20211029_021520648.jpg
