c3h899/Full-Range-Speaker/System Response (REW + MiniDSP UMIK I)/Preliminary Testing/9c-Measured Response (WiP3 Crossover).png

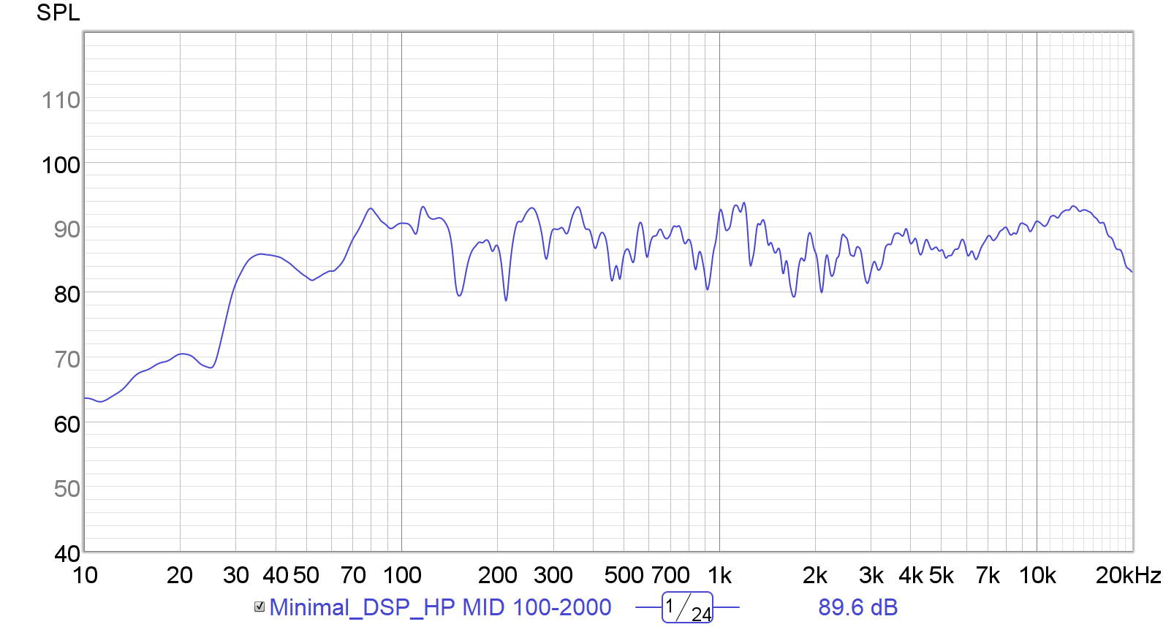
System Response (REW + MiniDSP UMIK I)/Preliminary Testing/9c-Measured Response (WiP3 Crossover).png
