c3h899/Full-Range-Speaker/Power_Amplifier/Amp_Schematic.pdf

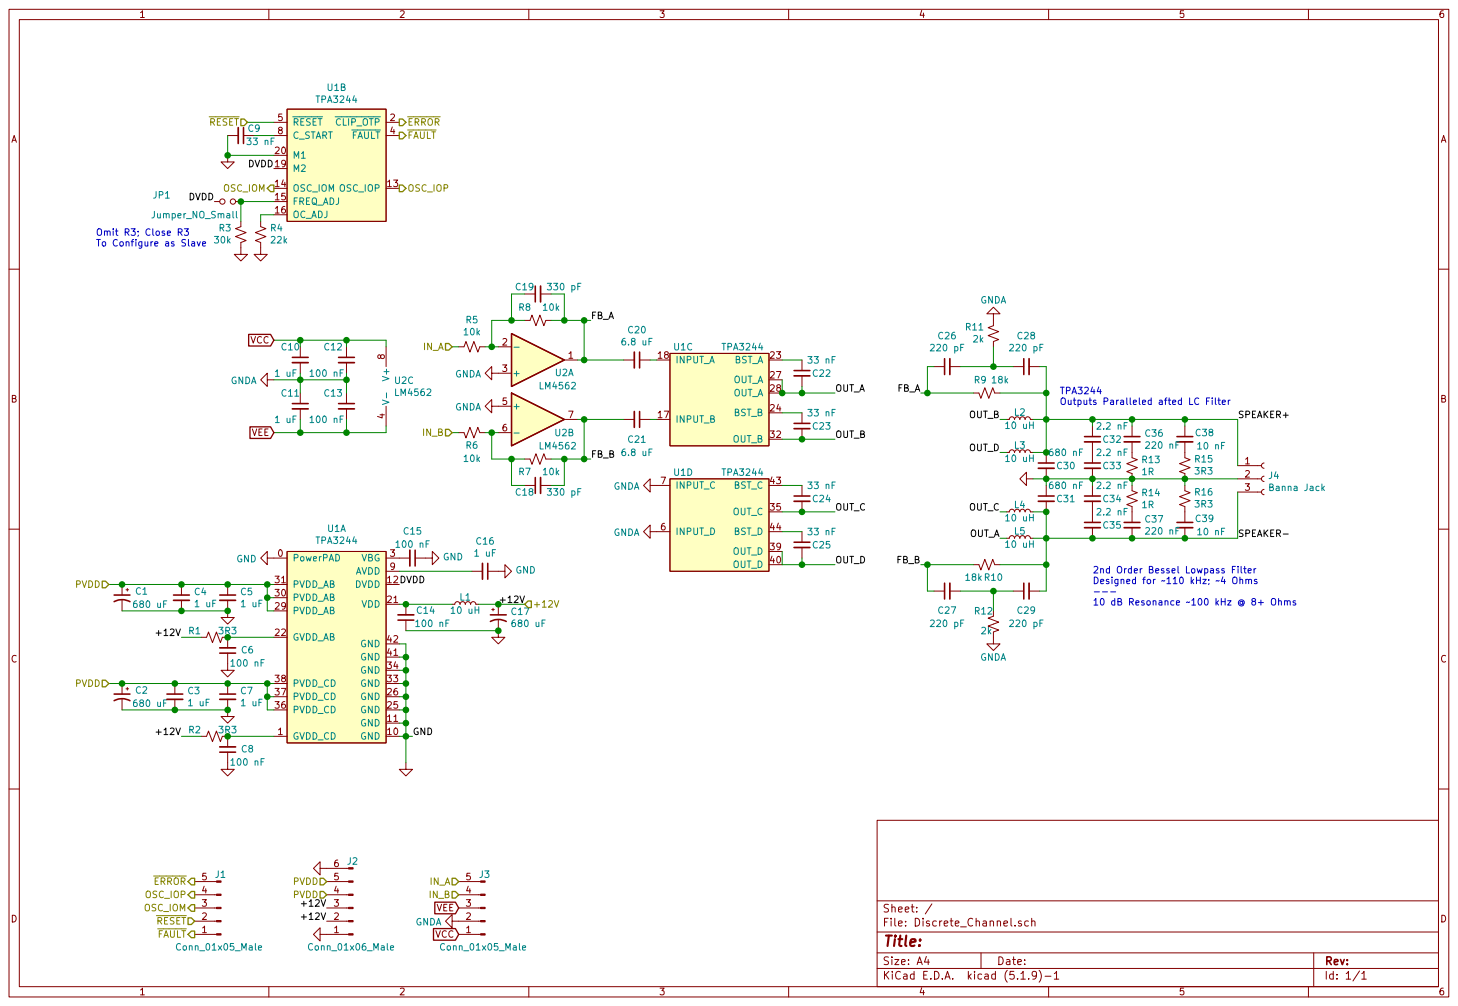
[picture p84: page 1]

2nd Order Bessel Lowpass Filter
Designed for 110 kHz; 4 Ohms
--- 10 dB Resonance 100 kHz @ 8+ Ohms
