c3h899/Full-Range-Speaker/Crossover Designs/Active/LTSpice_Sim/Active_Cross.asc

C1: cap; 100nF
C2: cap; 47nF
C3: cap; 33nF
C4: cap; 220nF
C5: cap; 10nF
C6: cap; 10nF
C7: cap; 1µF
R1: res; 13k
R2: res; 39k
R3: res; 10k
R4: res; 2k
R5: res; 4.7k
R6: res; 5.1k
R7: res; 5.6k
R8: res; 11k
R9: res; 5.6k
R10: res; 10k
R11: res; 10k
U1: OP213
U2: OP213
U3: OP213
U4: OP213
V1: voltage; 12
V2: voltage; 12
V3: voltage; ""; AC 1 0
Named nets: 0, VCC, VEE, LPF, BPF, AC, HPF
.ac dec 100 10 100E3
http://sim.okawa-denshi.jp/en/OPttool.php
http://sim.okawa-denshi.jp/en/OPstool.php
http://sim.okawa-denshi.jp/en/OPstool.php
