c3h899/Full-Range-Speaker/Power_Amplifier/LTSpice_Sim/Amp_Output_Filter.asc

C1: cap; 620n
C2: cap; 1n
C3: cap; 10n
C4: cap; 620n
C5: cap; 1n
C6: cap; 10n
C7: cap; 680n
C8: cap; 1n
C9: cap; 10n
C10: cap; 680n
C11: cap; 1n
C12: cap; 10n
C13: cap; 560n
C14: cap; 1n
C15: cap; 10n
C16: cap; 560n
C17: cap; 1n
C18: cap; 10n
C19: cap; 10µ
L1: ind; 11µ
L2: ind; 11µ
L3: ind; 11µ
L4: ind; 11µ
L6: ind; 10µ
L7: ind; 10µ
L9: ind; 9.1µ
L10: ind; 9.1µ
L11: ind; 9.1µ
L12: ind; 9.1µ
L13: ind; 10µ
L14: ind; 10µ
R1: res; 3.3
R2: res; 3.3
R3: res; 16
R4: res; 3.3
R5: res; 3.3
R6: res; 4
R7: res; 3.3
R8: res; 3.3
R9: res; 4
R10: res; 10k
V1: voltage; ""; AC 1 0
V2: voltage; ""; AC 1 0
V3: voltage; ""; AC 1 0
V4: voltage; ""; AC 1 0
V5: voltage; ""; AC 1 0
V6: voltage; ""; AC 1 0
V7: voltage; ""; AC 1 0
Named nets: 0
.ac dec 100 10 1E6
Reference::Hot at 8 Ohms
