c3h899/Full-Range-Speaker/Power_Amplifier/Discrete_Channel.kicad_pcb

## KiCad design Power_Amplifier/Discrete_Channel.kicad_pcb (2022-01-16)

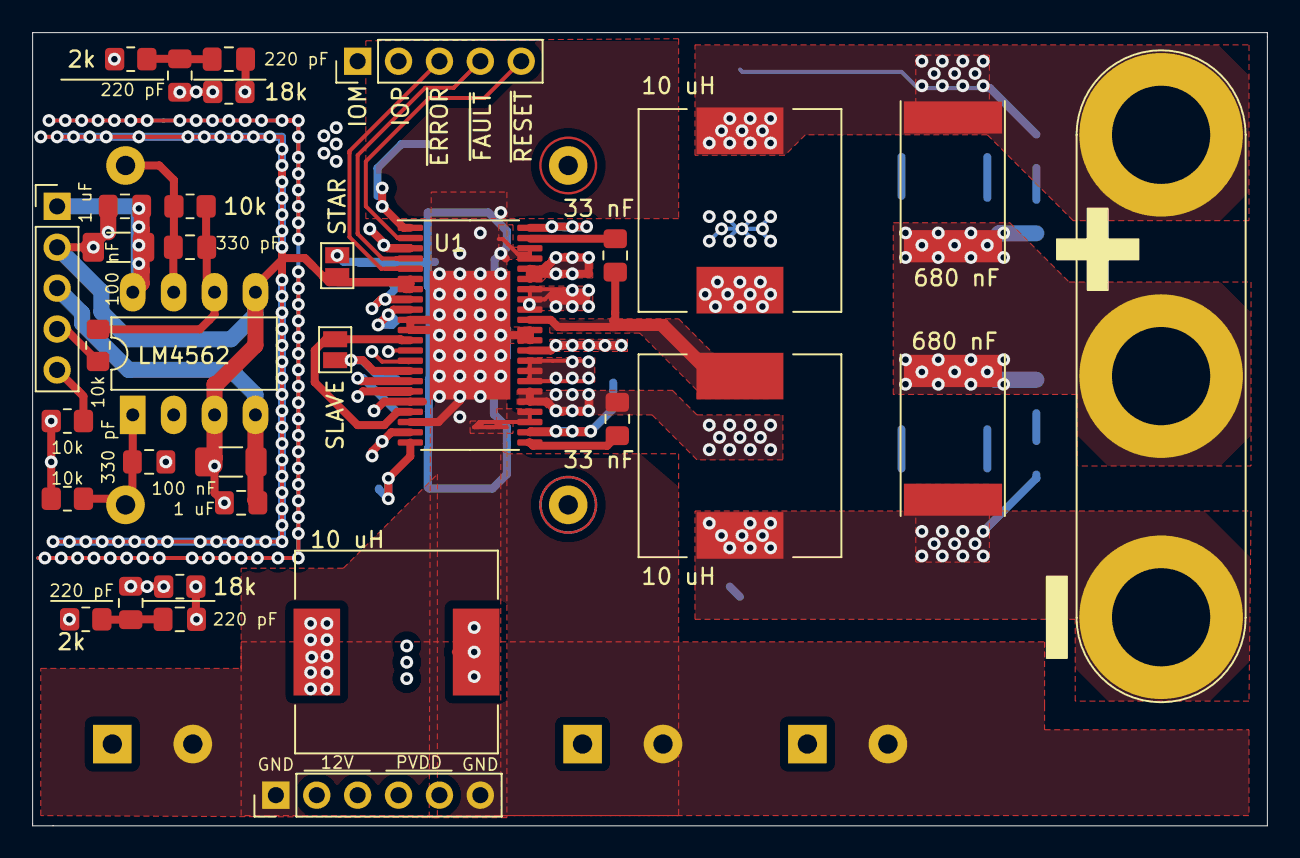
[picture p85: board Discrete_Channel.kicad_pcb from above]

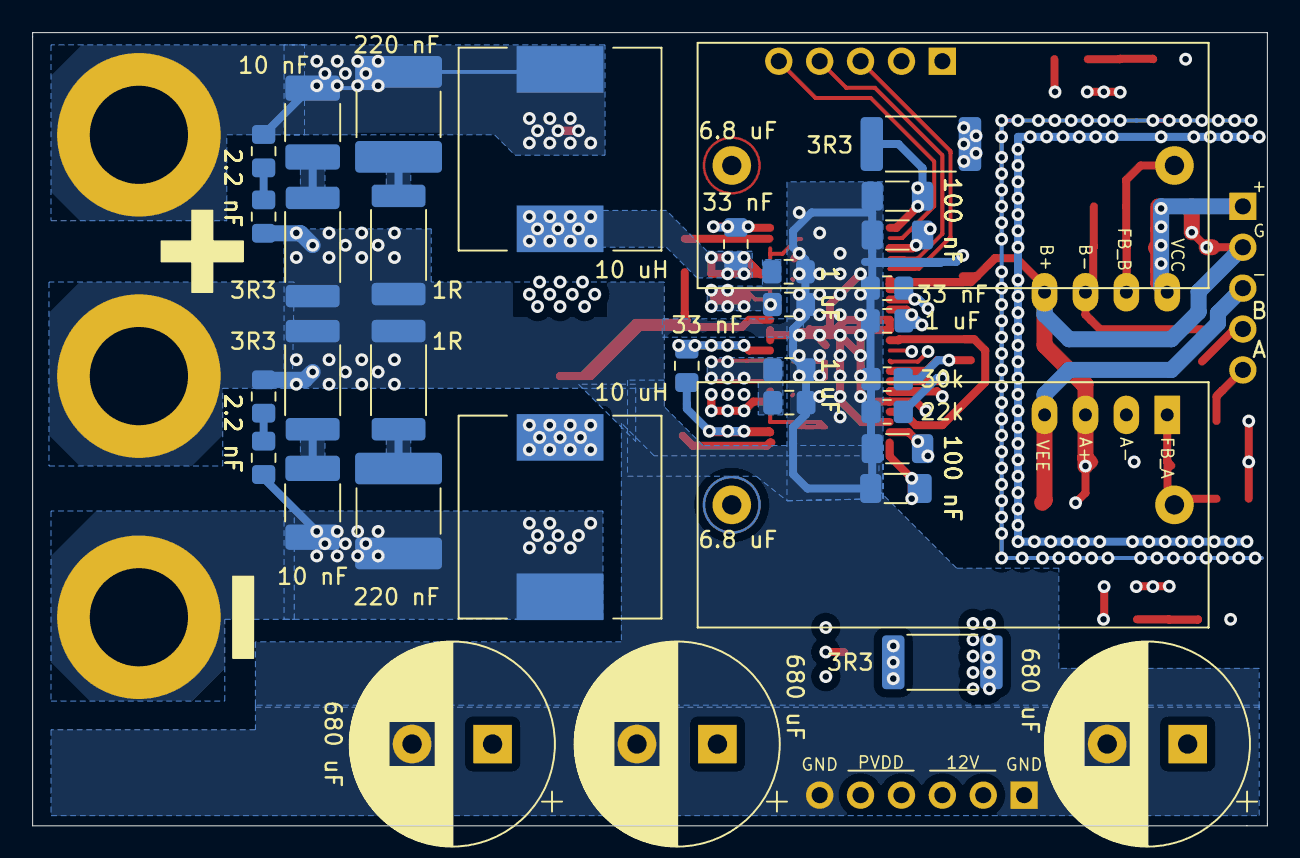
[picture p86: board Discrete_Channel.kicad_pcb from below]

Board: 4 copper layers, 76.7 x 49.3 mm, 68 parts (35 on the bottom side), 46 nets.

Parts:
C1, C2, C17: 680 uF; CP_Radial_D12.5mm_P5.00mm
C3, C4, C5, C7, C10, C11, C16: 1 uF; C_0805_2012Metric_Pad1.18x1.45mm_HandSolder
C6, C8, C12, C13, C14, C15: 100 nF; C_1206_3216Metric_Pad1.33x1.80mm_HandSolder
C9, C22, C23, C24, C25: 33 nF; C_0805_2012Metric_Pad1.18x1.45mm_HandSolder
C18, C19: 330 pF; C_0805_2012Metric_Pad1.18x1.45mm_HandSolder
C20, C21: 6.8 uF; C_Rect_L31.5mm_W15.0mm_P27.50mm_MKS4
C26, C27, C28, C29: 220 pF; C_0805_2012Metric_Pad1.18x1.45mm_HandSolder
C30, C31: 680 nF; C_2824
C32, C33, C34, C35: 2.2 nF; C_0805_2012Metric_Pad1.18x1.45mm_HandSolder
C36, C37: 220 nF; C_2220_5650Metric_Pad1.97x5.40mm_HandSolder
C38, C39: 10 nF; C_1812_4532Metric_Pad1.57x3.40mm_HandSolder
J1, J3: Conn_01x05_Male; PinHeader_1x05_P2.54mm_Vertical
J2: Conn_01x06_Male; PinHeader_1x06_P2.54mm_Vertical
J4: Banna Jack; Banana_Jack_3Pin
L1, L2, L3, L4, L5: 10 uH; L_12x12mm_H6mm
R1, R2, R15, R16: 3R3; R_2512_6332Metric_Pad1.40x3.35mm_HandSolder
R3: 30k; R_0805_2012Metric_Pad1.20x1.40mm_HandSolder
R4: 22k; R_0805_2012Metric_Pad1.20x1.40mm_HandSolder
R5, R6, R7, R8: 10k; R_0805_2012Metric_Pad1.20x1.40mm_HandSolder
R9, R10: 18k; R_0805_2012Metric_Pad1.20x1.40mm_HandSolder
R11, R12: 2k; R_0805_2012Metric_Pad1.20x1.40mm_HandSolder
R13, R14: 1R; R_2512_6332Metric_Pad1.40x3.35mm_HandSolder
SLAVE: Jumper_NO_Small; SolderJumper-2_P1.3mm_Open_Pad1.0x1.5mm
STAR: Star_Point; SolderJumper-2_P1.3mm_Open_Pad1.0x1.5mm
U1: TPA3244; HTSSOP-44_6.1x14mm_P0.635mm_TopEP4.14x7.01mm
U2: LM4562; DIP-8_W7.62mm_LongPads

Connections:
/+12V: C17.1, J2.2, J2.3, L1.2, R1.2, R2.2
/DVDD: SLAVE.1, U1.12, U1.19
/FB_A: C19.2, C20.2, C26.1, R8.1, R9.1, U2.1
/FB_B: C18.2, C21.2, C27.1, R7.1, R10.2, U2.7
/IN_A: J3.5, R5.2
/IN_B: J3.4, R6.2
/OSC_IOM: J1.1, U1.14
/OSC_IOP: J1.2, U1.13
/OUT_A: C22.2, L5.1, U1.27, U1.28
/OUT_B: C23.2, L2.1, U1.32
/OUT_C: C24.2, L4.1, U1.35
/OUT_D: C25.2, L3.1, U1.39, U1.40
/PVDD: C1.1, C2.1, C3.1, C4.1, C5.1, C7.1, J2.4, J2.5, U1.29, U1.30, U1.31, U1.36, U1.37, U1.38
/SPEAKER+: C28.2, C30.1, C32.1, C36.1, C38.1, J4.1, L2.2, L3.2, R9.2
/SPEAKER-: C29.2, C31.2, C35.2, C37.2, C39.2, J4.3, L4.2, L5.2, R10.1
/~ERROR: J1.5, U1.2
/~FAULT: J1.4, U1.4
/~RESET: J1.3, U1.5
GND: C1.2, C2.2, C3.2, C4.2, C5.2, C6.1, C7.2, C8.1, C9.2, C14.1, C15.1, C16.1, C17.2, C30.2, C31.1, C33.2, C34.1, J2.1, J2.6, J4.2, R3.1, R4.1, R13.2, R14.1, R15.1, R16.2, STAR.1, U1.0, U1.10, U1.11, U1.20, U1.25, U1.26, U1.33, U1.34, U1.41, U1.42
GNDA: C10.2, C11.1, C12.2, C13.1, J3.2, R11.2, R12.2, STAR.2, U1.6, U1.7, U2.3, U2.5
unnamed: C6.2, R1.1, U1.22
unnamed: C8.2, R2.1, U1.1
unnamed: C9.1, U1.8
unnamed: C14.2, L1.1, U1.21
unnamed: C15.2, U1.3
unnamed: C16.2, U1.9
unnamed: C18.1, R6.1, R7.2, U2.6
unnamed: C19.1, R5.1, R8.2, U2.2
unnamed: C20.1, U1.18
unnamed: C21.1, U1.17
unnamed: C22.1, U1.23
unnamed: C23.1, U1.24
unnamed: C24.1, U1.43
unnamed: C25.1, U1.44
unnamed: C26.2, C28.1, R11.1
unnamed: C27.2, C29.1, R12.1
unnamed: C32.2, C33.1
unnamed: C34.2, C35.1
unnamed: C36.2, R13.1
unnamed: C37.1, R14.2
unnamed: C38.2, R15.2
unnamed: C39.1, R16.1
unnamed: R3.2, SLAVE.2, U1.15
unnamed: R4.2, U1.16
VCC: C10.1, C12.1, J3.1, U2.8
VEE: C11.2, C13.2, J3.3, U2.4
