c3h899/Full-Range-Speaker/(commit log)

2021-11-26 Initial Measurement / Calibration with Cabinet
2021-11-26 Comparison of Desired and Measured Reponse
    Single chamber for both mid-bass and sub. Modeling the mid-bass as a 2nd passive radiator in parallel with the intended reveals the low frequency cut-off response measured.
2021-12-04 Theoretical Design
    Passive Filter derived from mild optimization and component rejection for a 2nd-order Bessel response with (f1 = 200 Hz) and (f2 = 2000 Hz)
2022-01-02 Circuit R2
    Fixed Issue with heatsink pad shorting out amplifier.
    [Discrete_Channel-B_Cu.gbr, Discrete_Channel-B_Mask.gbr, Discrete_Channel-B_Paste.gbr, Discrete_Channel-B_SilkS.gbr, Discrete_Channel-Edge_Cuts.gbr, Discrete_Channel-F_Cu.gbr, Discrete_Channel-F_Mask.gbr, Discrete_Channel-F_Paste.gbr]
2022-01-11 Added LFE Out on Channel 4
    LFE output included on channel 4 for use with separate powered subwoofer.
2022-01-16 Renamed Directory
    Discrete_Channel --> Power_Amplifier
    Additional work done to report.
    Invoices Added.
    [BoM_Discrete_Channel.csv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]
